vauntro/rika-nex-airflow-controller/hardware/sensorbruecke-as5600/sensorbruecke-as5600-zeichnung.pdf

Fenster 17 × 11, Ecken R 1,5
(Ecken Ø 3 vorbohren, aussägen, feilen)

# Sensorbrücke AS5600 – Rückseite Luftbox

Werkstoff: Alu-Blech 2 mm · Maßstab 1:1 (A4 quer, ohne Seitenanpassung drucken) · Maße in mm · Stand 06.11.2026

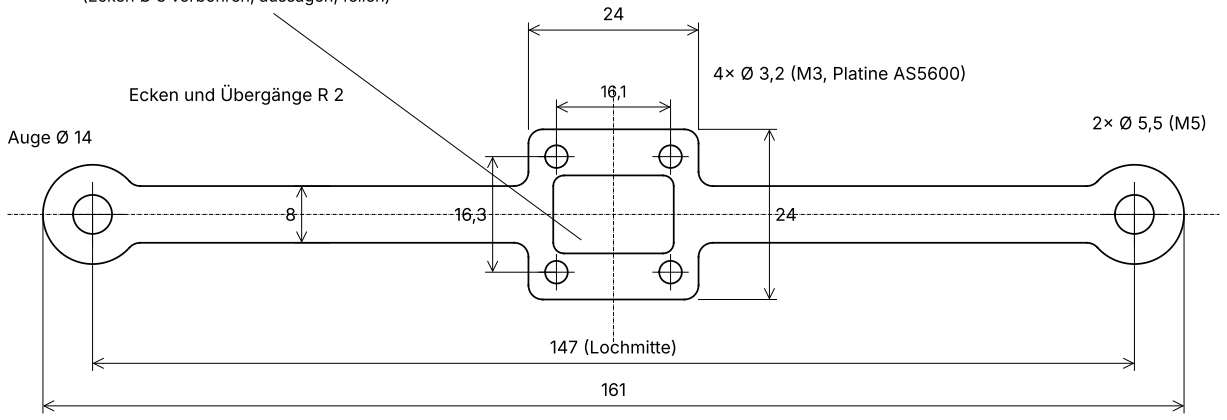
[picture p2: figure]
147 (Lochmitte); 4× Ø 3,2 (M3, Platine AS5600); Auge Ø 14; Ecken und Übergänge R 2

Prüfmaß 50 mm (beim Ausdruck nachmessen)

- Aufbau (von der Box aus): Lasche · Distanzhülse 12 mm · Brücke 2 mm · Scheibe · Mutter, Schraube ISO 4017 M5 × 30, Mutter DIN 985
- Laschenlöcher Ø 6,8 geben ca. ±0,6 mm Spiel: Brücke beim Anziehen so ausrichten, dass das Fenster mittig über der Welle sitzt.
- Platine mit Chip zur Welle auf der Box-Seite der Brücke, 4 Abstandshalter M3 × 6 (Innen/Innen), Schrauben M3 × 5.
- Stack: Magnet 1 vor Laschenebene + Luftspalt ca. 1,9 + Chip 1,5 + Platine 1,6 + Abstandshalter 6 = 12 (Hülsenlänge).
- Luftspalt einstellen: Scheibe M3 zwischen Abstandshalter und Brücke verkleinert den Spalt (je ca. 0,5 mm); Abstandshalter 5 mm → Spalt ca. 2,9 mm.
- AS5600 arbeitet mit Spalt ca. 0,5–3 mm; Feldstärke nach Montage per Firmware prüfen (Status MD/ML/MH).
- Fenster: Dupont-Stecker der Stiftleisten (Stifte zeigen von der Welle weg) gehen nach hinten durch. Platinenlage: Stiftreihen senkrecht.
