vauntro/rika-nex-airflow-controller/hardware/servohalter/bauteil-h-servohalter-abwicklung.pdf

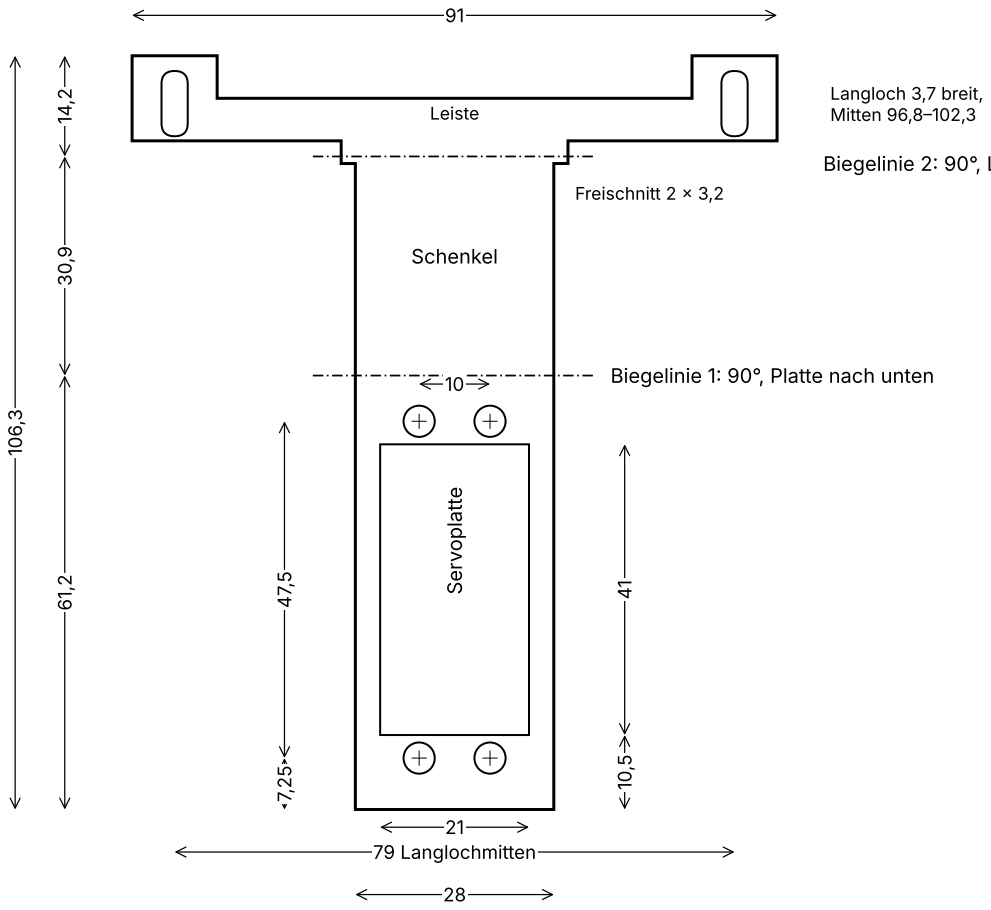
[picture p3: figure]
Biegelinie 1: 90°, Platte nach unten; Servoplatte; Schenkel; Leiste; 79 Langlochmitten; Langloch 3,7 breit, Mitten 96,8–102,3; Freischnitt 2 × 3,2

Biegelinie 2: 90°, Leiste nach unten (gleiche Richtung wie 1)

Kontrolle: 50 mm

Bauteil H – Servohalter, Abwicklung 1:1 (Alublech 2 mm, Biegeradius innen ≈ 2 mm)
Drucken mit 100 % / „Tatsächliche Größe“, dann die 50-mm-Kontrolllinie nachmessen.
Beide Biegungen in dieselbe Richtung: Platte und Leiste zeigen danach nach unten.
Langlöcher am besten erst nach dem Biegen bohren und vorher an der Luftbox den Kanalabstand prüfen (hier 79 mm). Servo-Lochbild 10 × 47,5 vor dem Bohren am Servo nachmessen.
