vauntro/rika-nex-airflow-controller/docs/rika-nex-manuelle-luftsteuerung.md

# RIKA NEX: manuelle Luftsteuerung

Zusammenfassung der manuellen Luftsteuerung und der dokumentierten Fühlerposition. Zur Luftsteuerung siehe das Kapitel **„Manuelle Bedienung“, Seite 12** der NEX-Anleitung.[1]

## Funktionsprinzip

Ein gemeinsamer Regler steuert Primär- und Sekundärluft. Die Mittelstellung bedeutet nicht „halbe Luftmenge“.[1]

| Reglerstellung | Primärluft | Sekundärluft |
|---|---|---|
| Anheizstellung | 100 % offen | 100 % offen |
| Mittelstellung | geschlossen | 100 % offen |
| Nullstellung | geschlossen | geschlossen |

Von der Mittelstellung Richtung Null wird die Sekundärluft gedrosselt.[1]

## Luftwege

- **Primärluft / Unterluft:** gelangt durch Aschenraum und Rost von unten zum Brennstoff und dient insbesondere dem Anheizen.[2]
- **Sekundärluft / Oberluft:** strömt entlang der Scheibeninnenseite in den Feuerraum, unterstützt die Verbrennung der Holzgase und dient als Scheibenspülung. Nach dem Anheizen erfolgt die Regelung über diesen Luftweg.[2]

## Bedienablauf

1. **Anheizen:** beide Luftwege öffnen.
2. **Nach dem Anheizen:** auf Mittelstellung wechseln, anschließend bei Bedarf weiter Richtung Null regeln.
3. **Nachlegen:** erneut Anheizstellung wählen, bis das nachgelegte Holz gut angebrannt ist.[1]

Die passende Einstellung hängt unter anderem von Kaminzug, Holzqualität und Auflagemenge ab; feste Minutenwerte sind nicht vorgegeben.[1]

> **Sicherheit:** Die Nullstellung darf während des Betriebs nicht verwendet werden – Verpuffungsgefahr. Sie ist für den Stillstand vorgesehen.[1]

## Position des Brennraumtemperaturfühlers

Die folgende Lagebeschreibung ist aus der Wartungsabbildung auf **Seite 19** der NEX-Anleitung abgeleitet. Als Blickrichtung gilt der Blick durch die geöffnete Feuerraumtür nach oben in den Brennraum.[3]

- **Höhenlage:** Der Fühler befindet sich ganz oben im Brennraum, im Bereich der oberen Umlenkplatte beziehungsweise der Brennraumdecke, deutlich oberhalb des Holzauflagebereichs.[3]
- **Sichtbare Stelle:** Die kurze Fühlerspitze ist in einer schmalen, länglichen Aussparung der oberen Platte erkennbar.[3]
- **Eintritt in die Aussparung:** Die Spitze ragt seitlich in diese Öffnung hinein; sichtbar ist nur das kurze, freiliegende Fühlerende.[3]
- **Seitliche Zuordnung:** Die Aussparung liegt in der Herstellerzeichnung links von der Bildmitte. Diese Angabe bezieht sich auf die dargestellte Ansicht und ist keine vermaßte Links-rechts-Position am Ofen.[3]
- **Räumliche Abgrenzung:** Der dargestellte Messort liegt im oberen Brennraumbereich, nicht am Rost und nicht außen am Rauchrohr.[3]

**Genauigkeitsgrenze:** Die Abbildung enthält keine Maße für Einstecktiefe, Wandabstand oder Höhe über dem Rost. Der verdeckte Fühlerverlauf und seine Befestigung lassen sich daraus nicht zuverlässig bestimmen. Die Beschreibung legt daher die erkennbare Position fest, nicht millimetergenaue Einbaumaße.[3]

## Grenzen der Dokumentation

Die Anleitung dokumentiert die Grundstellungen und den Bedienablauf, jedoch keine quantitative Kennlinie für Zwischenstellungen oder genaue innere Schiebergeometrie. Aus dem prozentualen Reglerweg lässt sich deshalb keine belegte prozentuale Luftmenge ableiten.[1]

## Sources

[1] https://rika.ams3.cdn.digitaloceanspaces.com/rika-web/ovens/nex/pdf/DE/Z36267_Nex_R4_DE.pdf
[2] https://www.rika.de/faqs
[3] https://www.ofenexperte.de/pub/more_downloads/rika-nex-rikatronic-bedienungsanleitung.pdf
