vauntro/rika-nex-airflow-controller/hardware/sensorbruecke-as5600/entwurf/skizze-sensorhalter-as5600.png

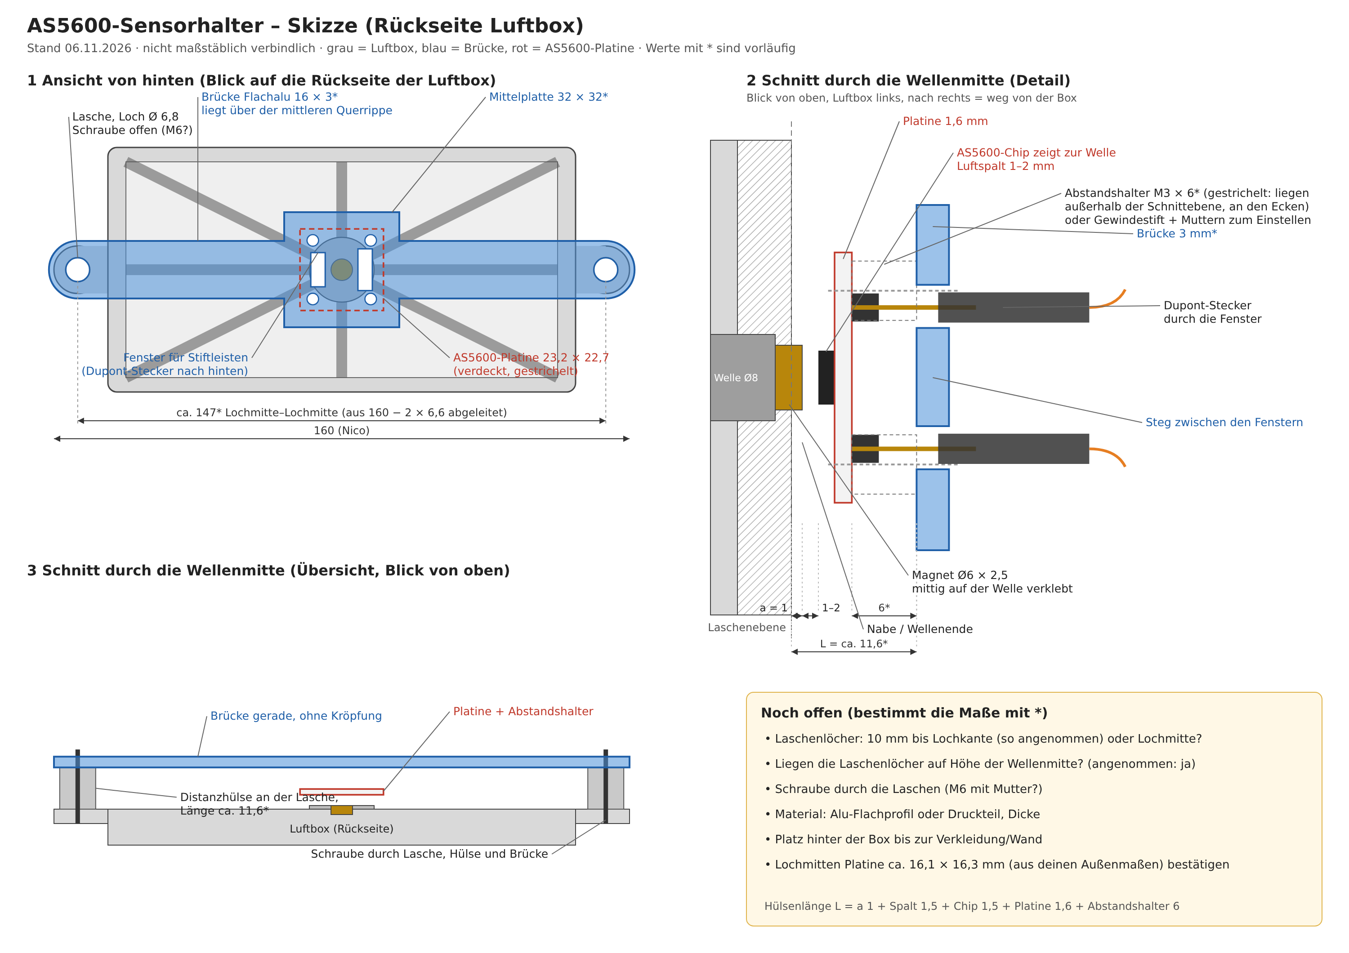
hardware/sensorbruecke-as5600/entwurf/skizze-sensorhalter-as5600.png
