vauntro/rika-nex-airflow-controller/hardware/sensorbruecke-as5600/entwurf/varianten-a-b.png

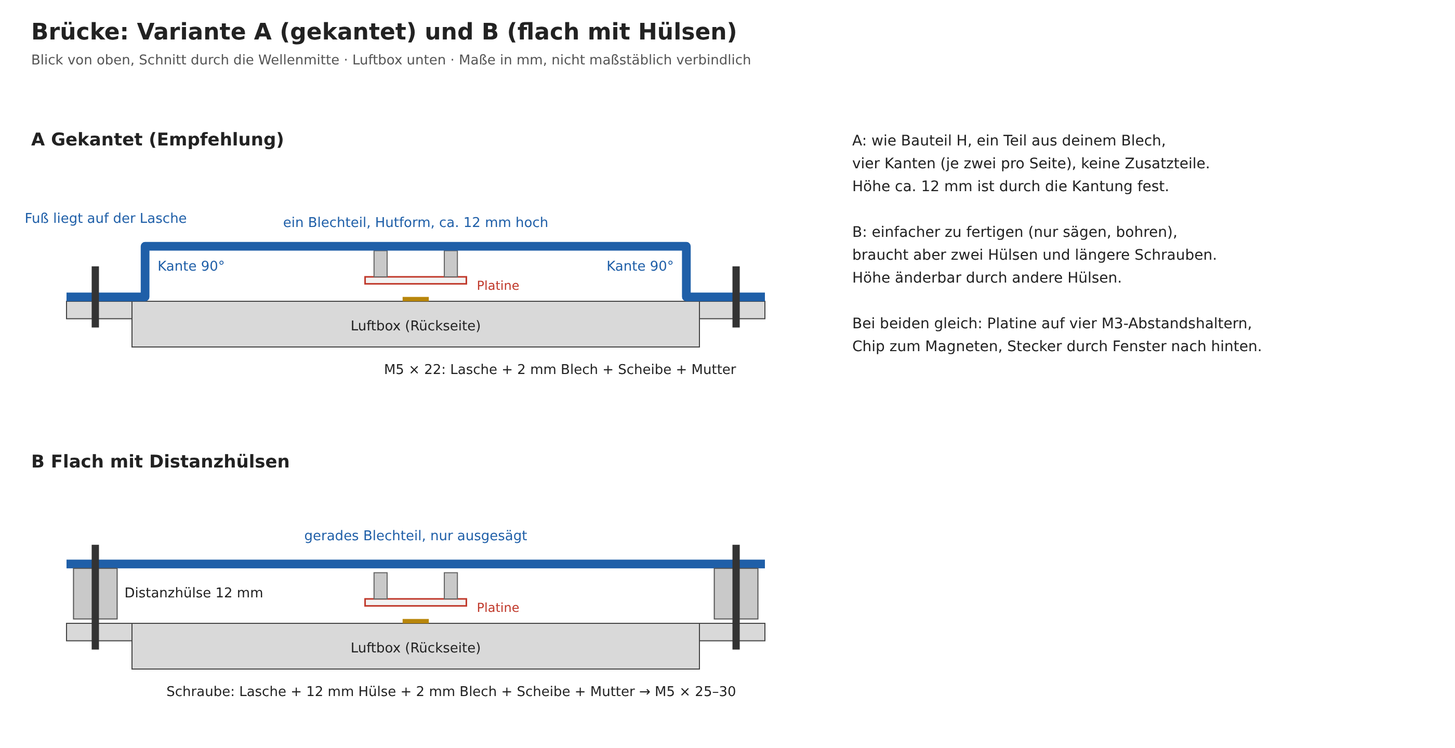
hardware/sensorbruecke-as5600/entwurf/varianten-a-b.png
