vauntro/rika-nex-airflow-controller/hardware/sensorbruecke-as5600/sensorbruecke-as5600-baugruppe.png

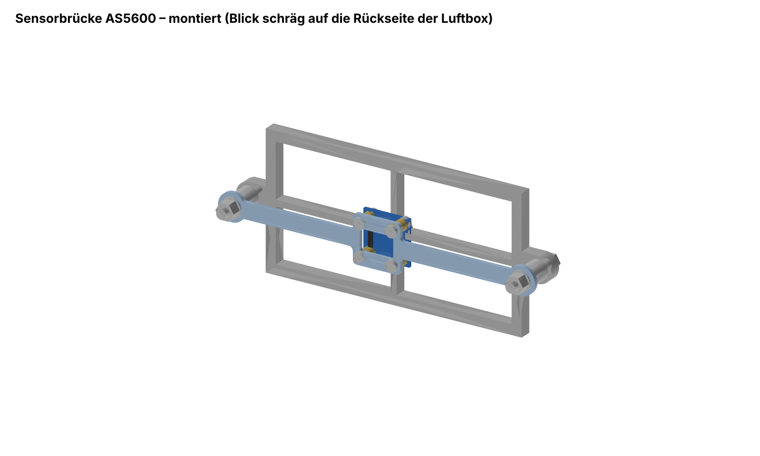
hardware/sensorbruecke-as5600/sensorbruecke-as5600-baugruppe.png
