vauntro/rika-nex-airflow-controller/hardware/sensorbruecke-as5600/sensorbruecke-as5600-zeichnung.png

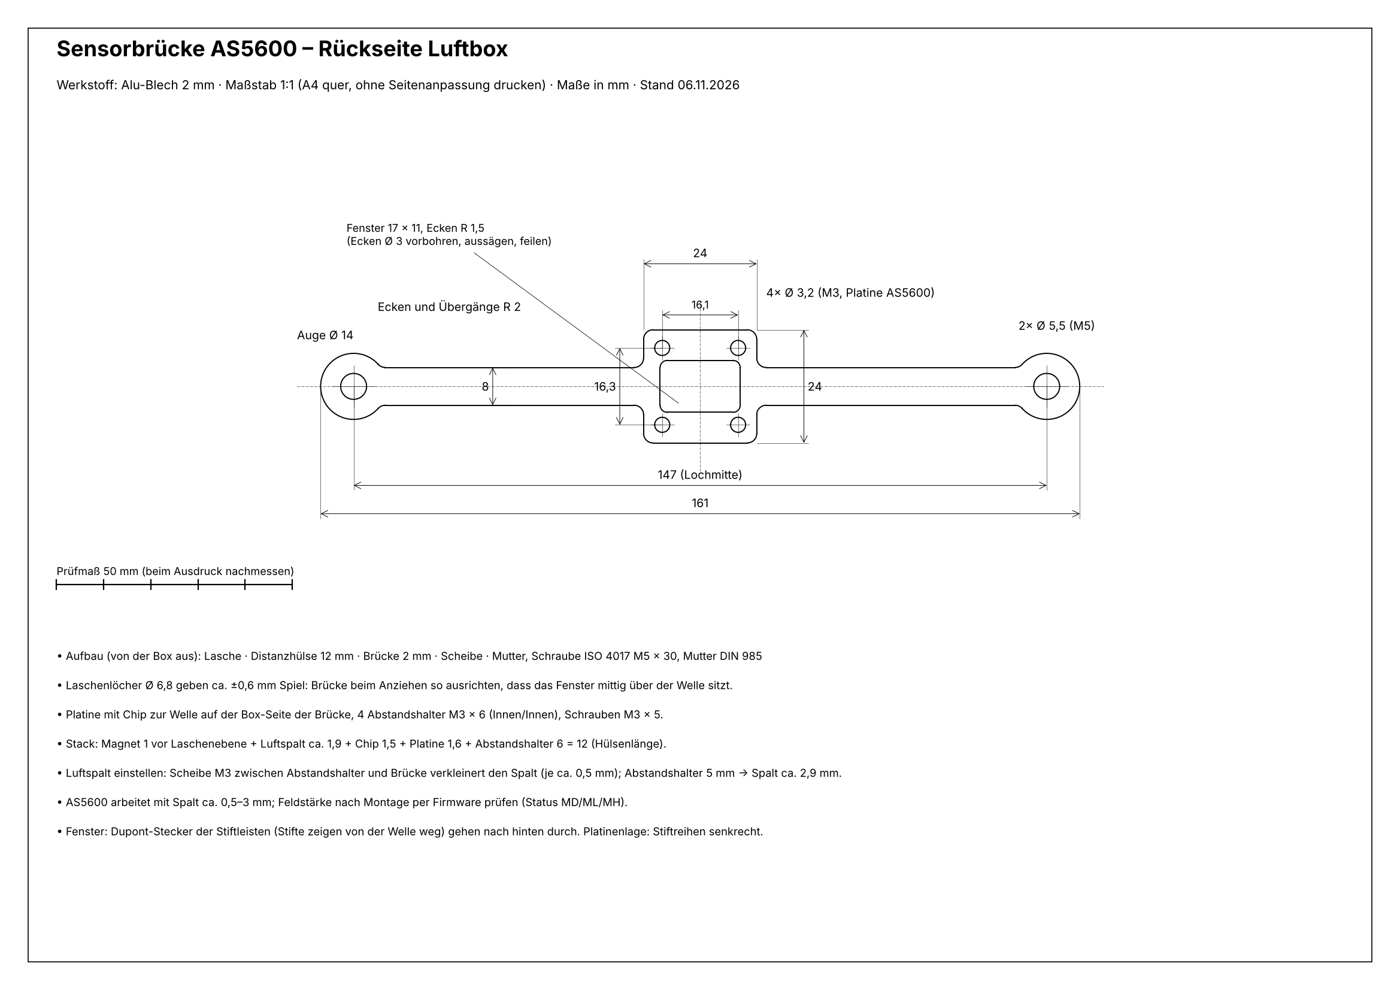
hardware/sensorbruecke-as5600/sensorbruecke-as5600-zeichnung.png
