vauntro/rika-nex-airflow-controller/hardware/servohalter/bauteil-h-servohalter-3d.png

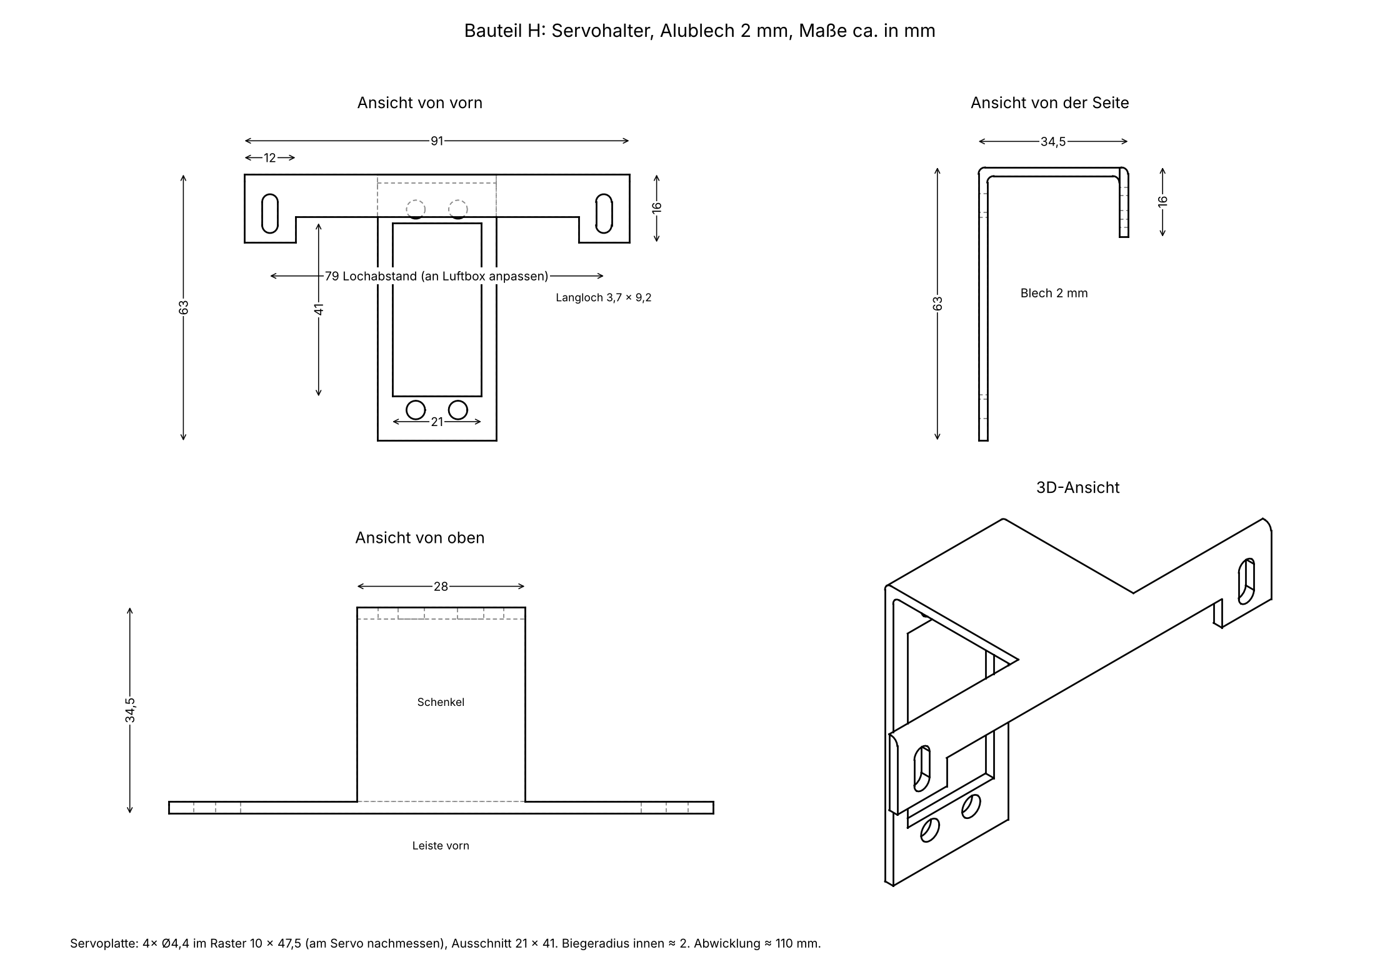
hardware/servohalter/bauteil-h-servohalter-3d.png
