vauntro/rika-nex-airflow-controller/hardware/servohalter/bauteil-h-servohalter-abwicklung.png

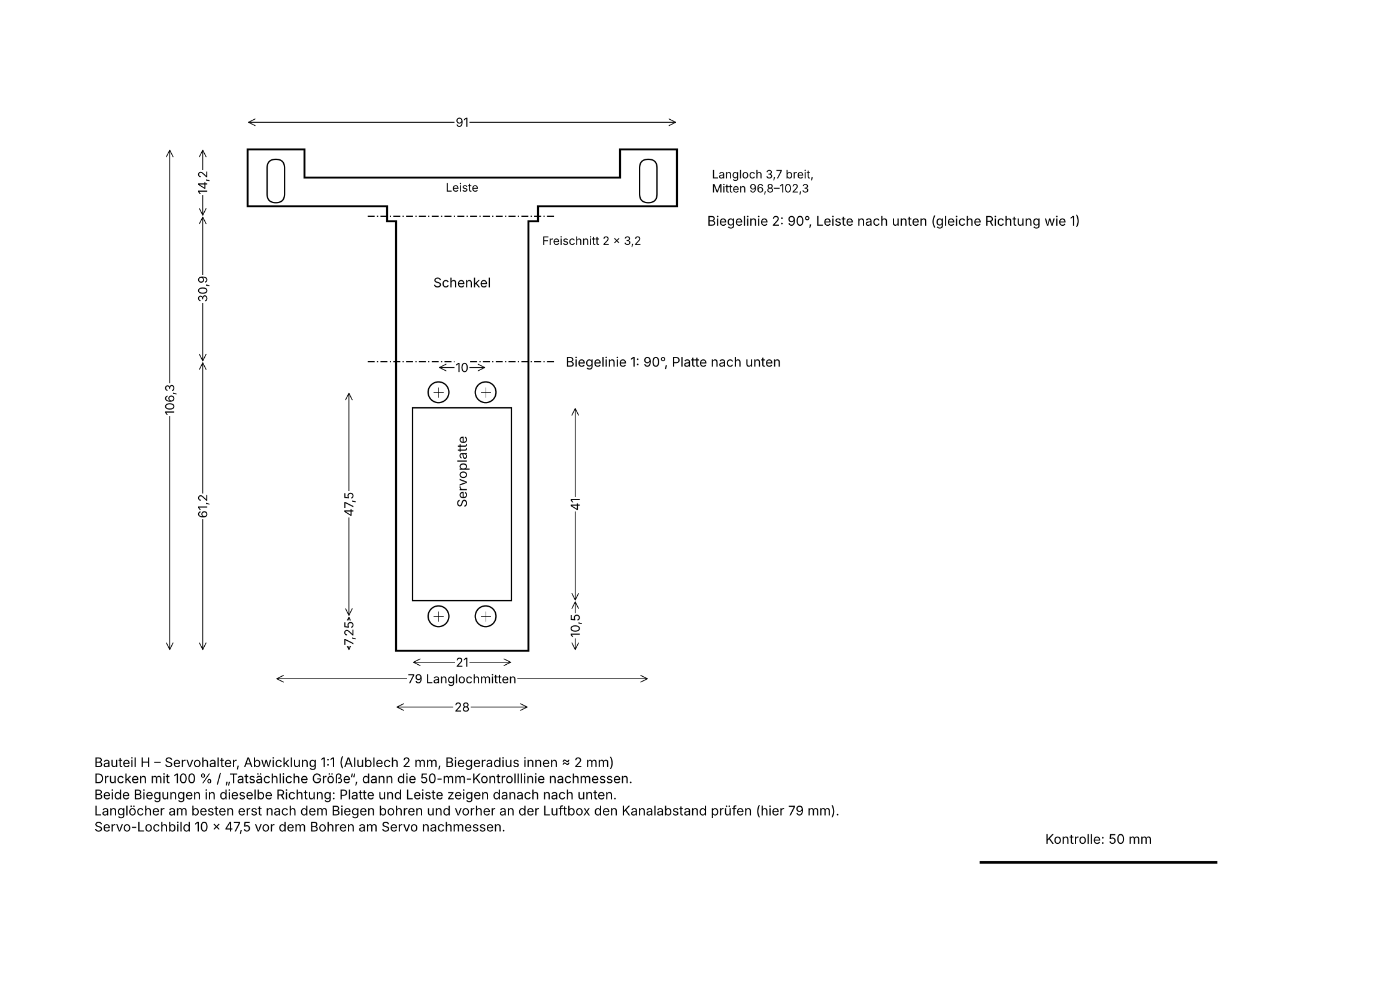
hardware/servohalter/bauteil-h-servohalter-abwicklung.png
