vauntro/rika-nex-airflow-controller/hardware/servohalter/bauteil-h-servohalter-masse.png

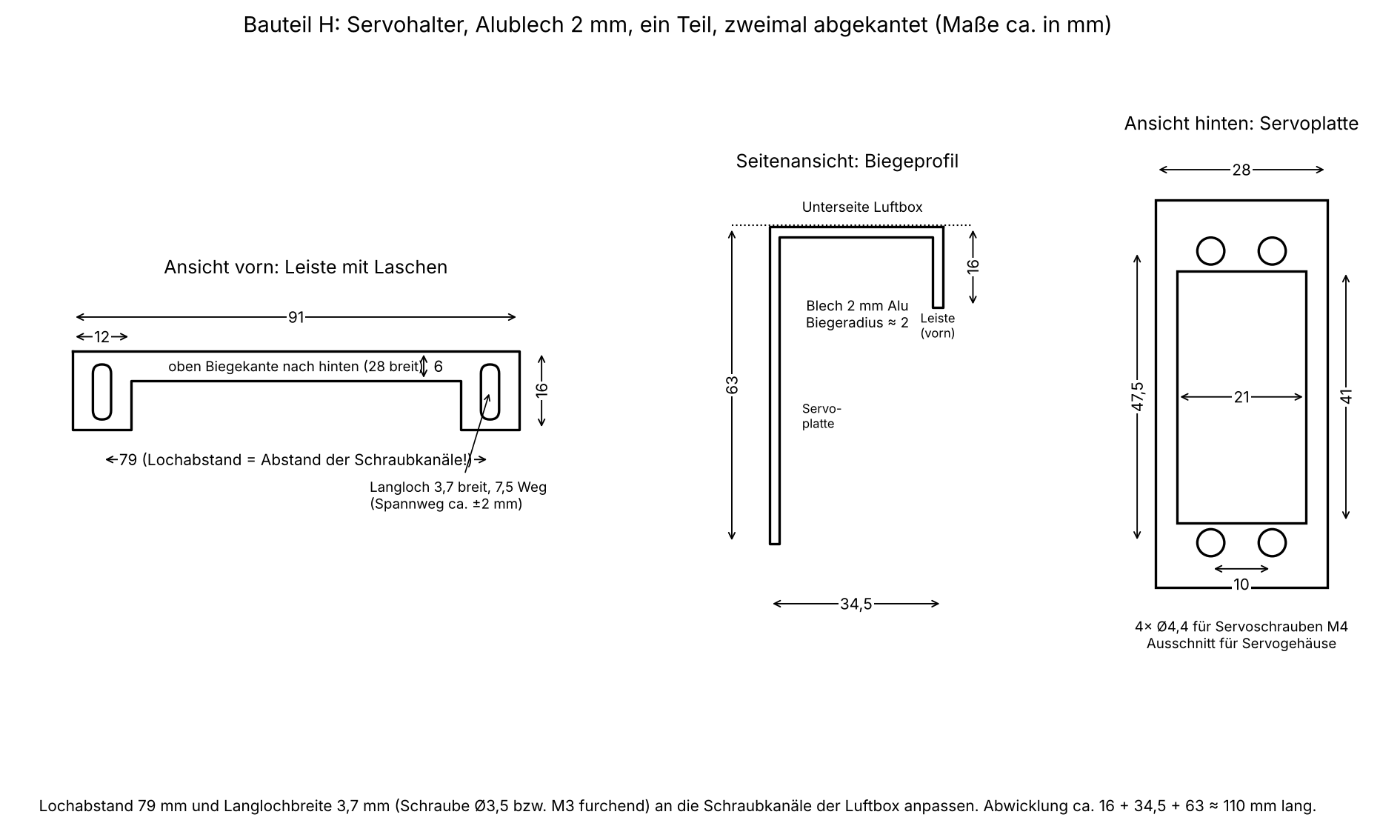
hardware/servohalter/bauteil-h-servohalter-masse.png
