vauntro/rika-nex-airflow-controller/hardware/sensorbruecke-as5600/sensorbruecke-as5600-baugruppe-explosion.step

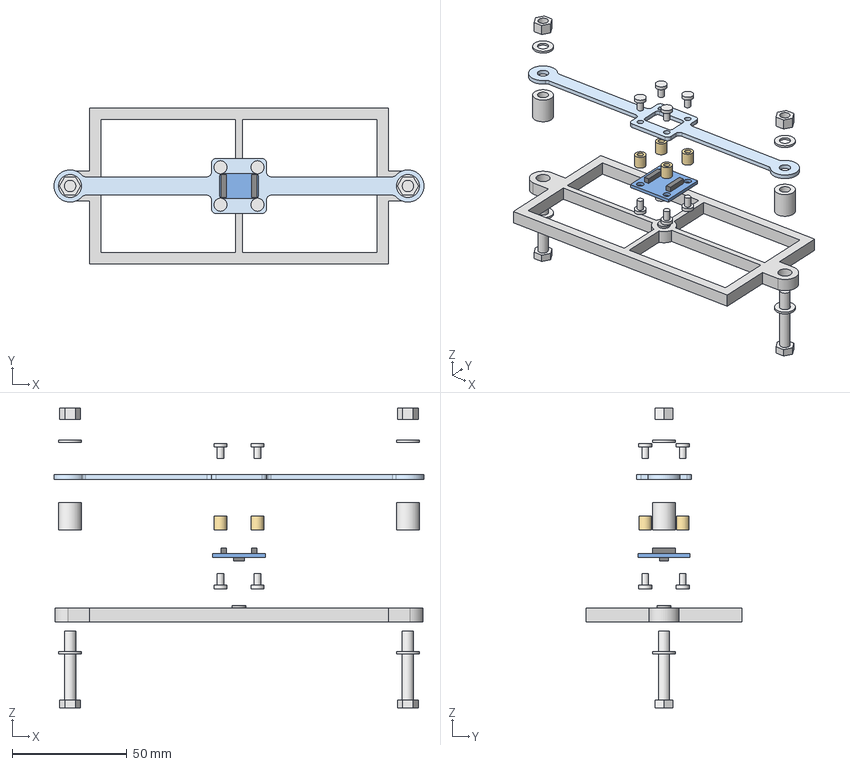
[picture p12: CAD file, 2026-11-06]
hardware/sensorbruecke-as5600/sensorbruecke-as5600-baugruppe-explosion.step
161.0 x 68.0 x 130.5 mm
01_Luftbox_Rueckseite_1
02_Magnet_1
07_ISO7380_M3x5_1
04_Abstandshalter_M3x6_1
07_ISO7380_M3x5_2
07_ISO7380_M3x5_3
04_Abstandshalter_M3x6_2
07_ISO7380_M3x5_4
07_ISO7380_M3x5_5
04_Abstandshalter_M3x6_3
07_ISO7380_M3x5_6
07_ISO7380_M3x5_7
04_Abstandshalter_M3x6_4
07_ISO7380_M3x5_8
03_AS5600_Platine_1
03_AS5600_Platine_2
03_AS5600_Platine_3
03_AS5600_Platine_4
05_Sensorbruecke_1
06_Distanzhuelse_12_1
09_Scheibe_ISO7089_5_1
10_Mutter_DIN985_M5_1
09_Scheibe_ISO7089_5_2
08_ISO4017_M5x30_1
06_Distanzhuelse_12_2
09_Scheibe_ISO7089_5_3
10_Mutter_DIN985_M5_2
09_Scheibe_ISO7089_5_4
08_ISO4017_M5x30_2
