vauntro/rika-nex-airflow-controller/hardware/riemenrad/riemenrad-gt2-20t-servo25t.step

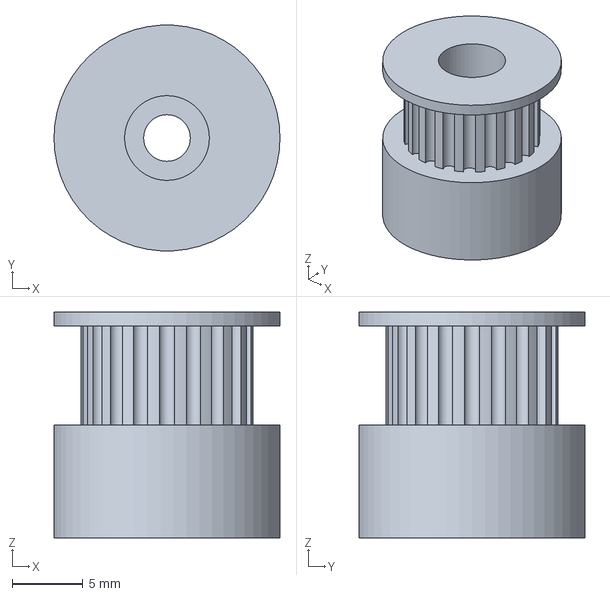
[picture p13: CAD file, 2026-10-27]
hardware/riemenrad/riemenrad-gt2-20t-servo25t.step
16.0 x 16.0 x 16.0 mm
