vauntro/rika-nex-airflow-controller/hardware/servohalter/bauteil-h-servohalter.step

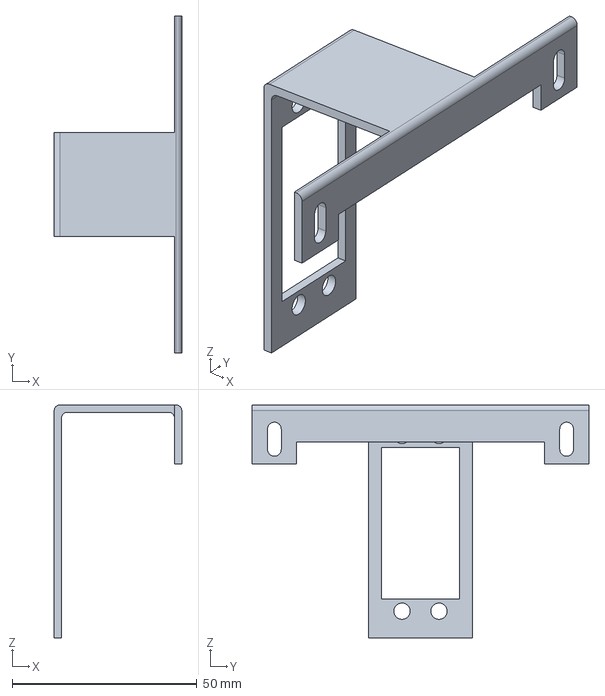
[picture p14: CAD file, 2026-10-27]
hardware/servohalter/bauteil-h-servohalter.step
34.5 x 91.0 x 63.0 mm
