vauntro/rika-nex-airflow-controller/hardware/sensorbruecke-as5600/sensorbruecke-as5600.step

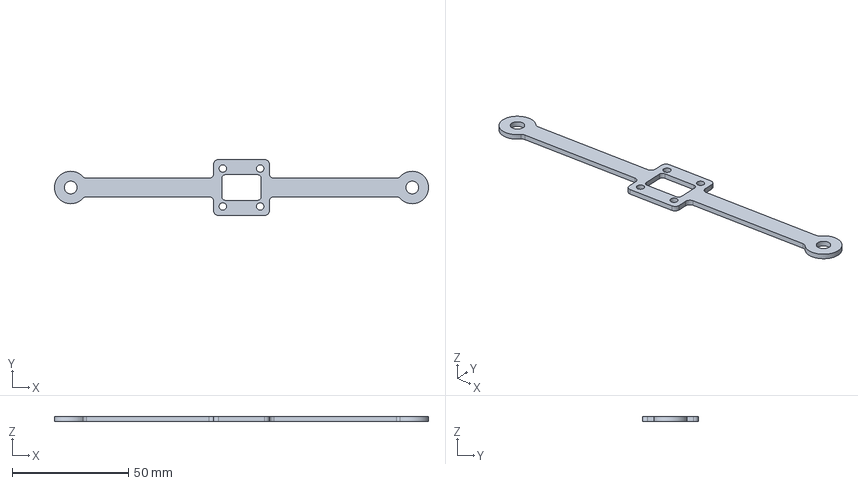
[picture p15: CAD file, 2026-11-06]
hardware/sensorbruecke-as5600/sensorbruecke-as5600.step
161.0 x 24.0 x 2.00 mm
