vauntro/rika-nex-airflow-controller/(list of files, cad)

Other CAD files:
hardware/riemenrad/riemenrad-gt2-20t-servo25t.stl
hardware/sensorbruecke-as5600/sensorbruecke-as5600-baugruppe-explosion.stl
hardware/sensorbruecke-as5600/sensorbruecke-as5600-baugruppe-montiert.stl
hardware/sensorbruecke-as5600/sensorbruecke-as5600.dxf
hardware/sensorbruecke-as5600/sensorbruecke-as5600.stl
hardware/servohalter/bauteil-h-servohalter.stl
