vauntro/rika-nex-airflow-controller/hardware/sensorbruecke-as5600/sensorbruecke-as5600-montage.pdf

# Sensorbrücke AS5600 – Montage (Explosionsdarstellung)

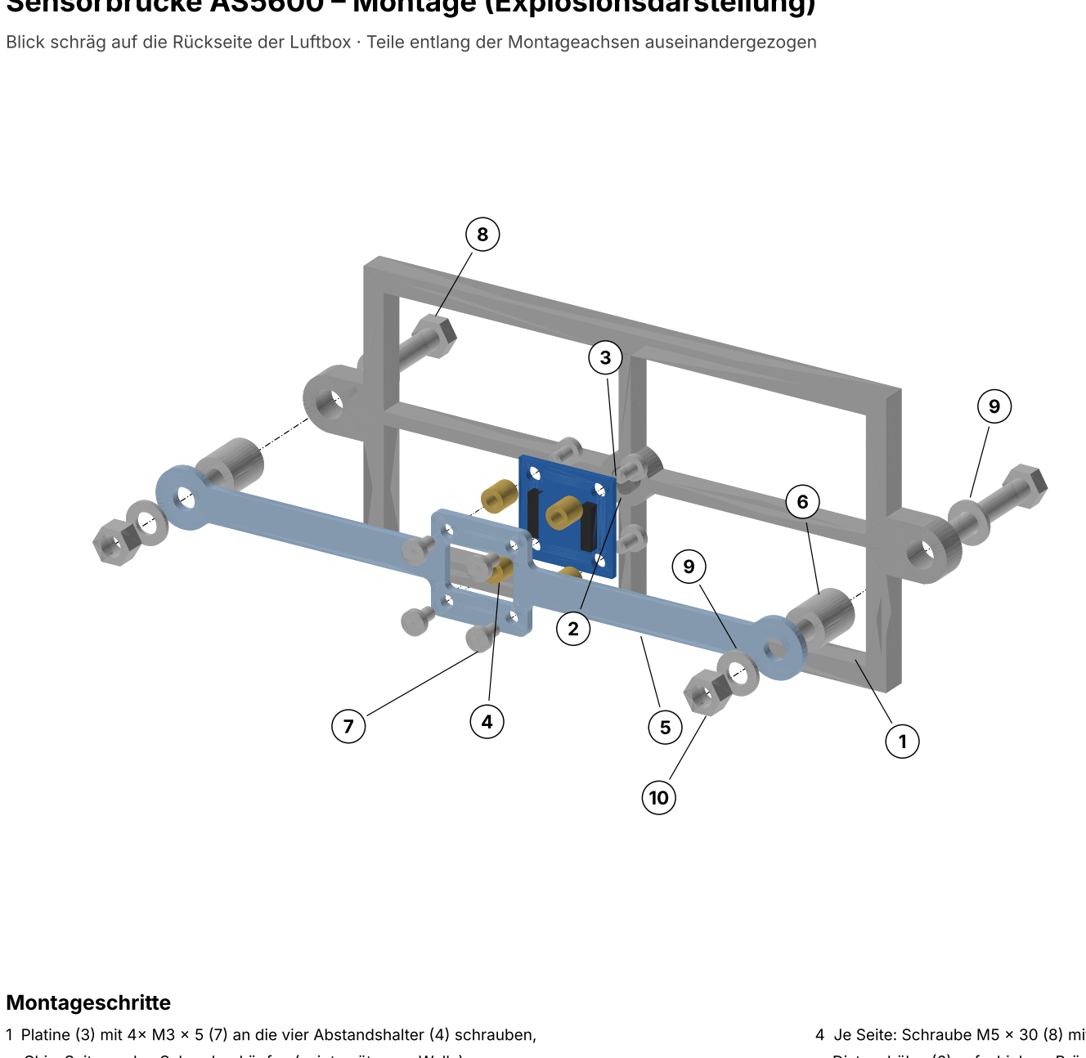
[picture p16: figure]
Montageschritte

Blick schräg auf die Rückseite der Luftbox · Teile entlang der Montageachsen auseinandergezogen

## Teileliste

Pos. Benennung | Stk.
1 | Luftbox-Rückseite, mittlere Laschen (6,2 dick, Ø6,8)vorhanden
2 | Magnet Ø6 × 2,5, mittig auf dem Wellenende | vorhanden
3 | AS5600-Platine, Chip zur Welle | 1
4 | Abstandshalter M3 × 6, innen/innen, Messing | 4
5 | Sensorbrücke, Alu 2 mm (RNX-S-001) | 1
6 | Distanzhülse 12, Ø10/5,3 | 2
7 | ISO 7380 M3 × 5 – A2 | 8
8 | ISO 4017 M5 × 30 – A2 | 2
9 | Scheibe ISO 7089 – 5 – A2 | 4
10 | Sicherungsmutter DIN 985 M5 – A2 | 2

1 Platine (3) mit 4× M3 × 5 (7) an die vier Abstandshalter (4) schrauben, Chip-Seite zu den Schraubenköpfen (zeigt später zur Welle).

2 Abstandshalter mit 4× M3 × 5 (7) von außen an der Brücke (5) befestigen,

Stiftleisten durch das Fenster, Stiftreihen senkrecht.

3 Dupont-Kabel durch das Fenster auf die Stiftleisten stecken.

4 Je Seite: Schraube M5 × 30 (8) mit Scheibe (9) von hinten durch die Lasche (1),

Distanzhülse (6) aufschieben, Brücke aufsetzen, Scheibe (9), Mutter (10) handfest.

5 Brücke ausrichten: Chip mittig über dem Magneten (2), dann Muttern anziehen.
6 Feldstärke prüfen (MD/ML/MH), ggf. Spalt mit M3-Scheiben unter den

Abstandshaltern verkleinern, Nullpunkt neu setzen.
