vauntro/rika-nex-airflow-controller/hardware/sensorbruecke-as5600/sensorbruecke-as5600-montage.png

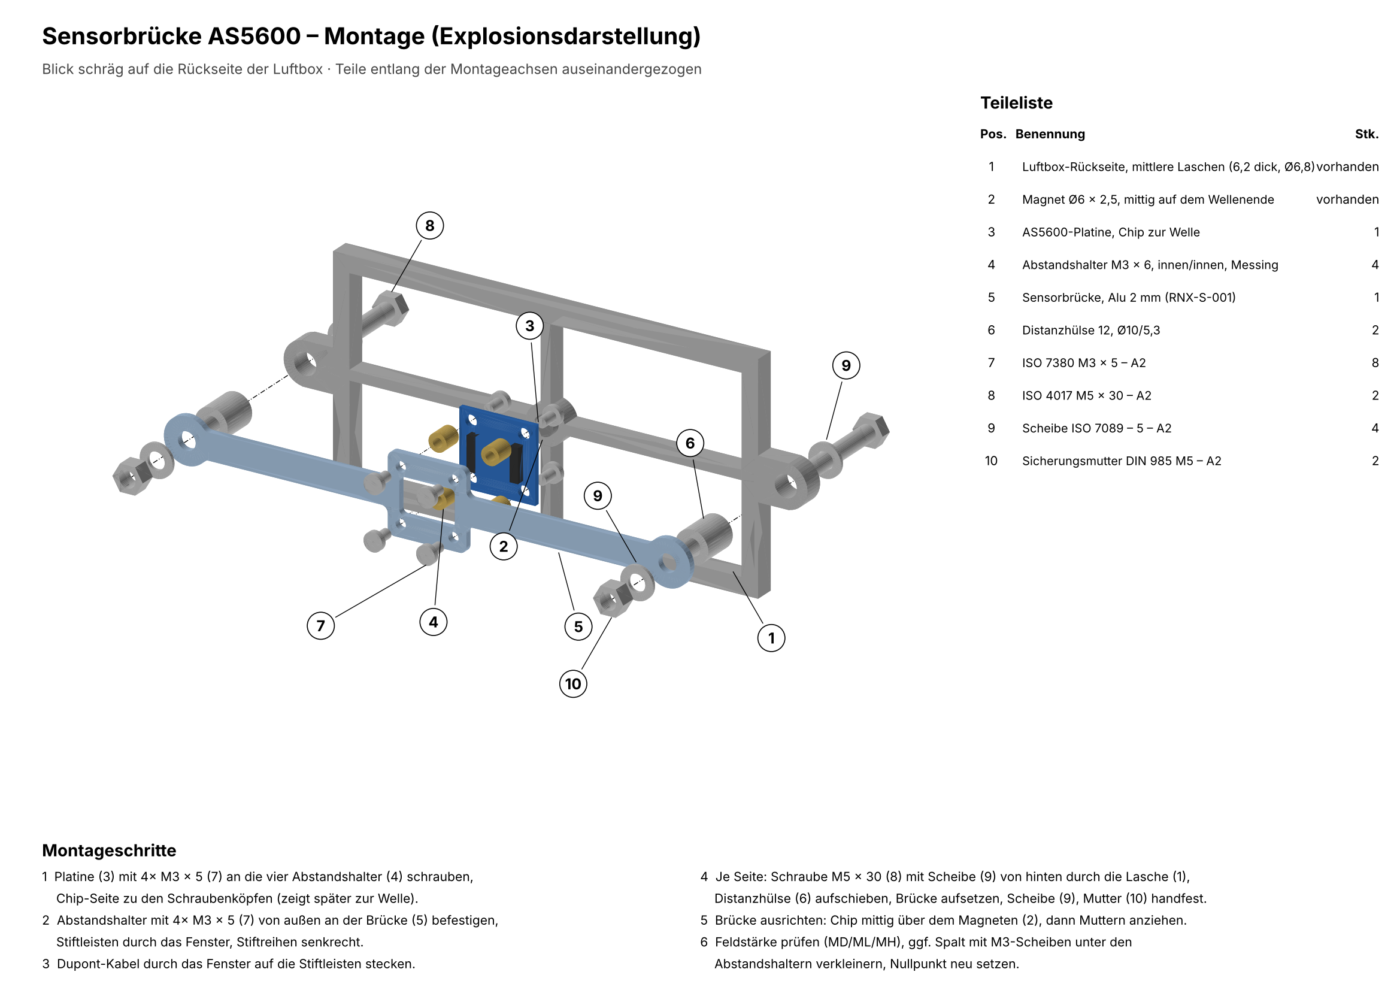
hardware/sensorbruecke-as5600/sensorbruecke-as5600-montage.png
