vauntro/rika-nex-airflow-controller/hardware/sensorbruecke-as5600/sensorbruecke-as5600-zeichnung-iso.pdf

1

2

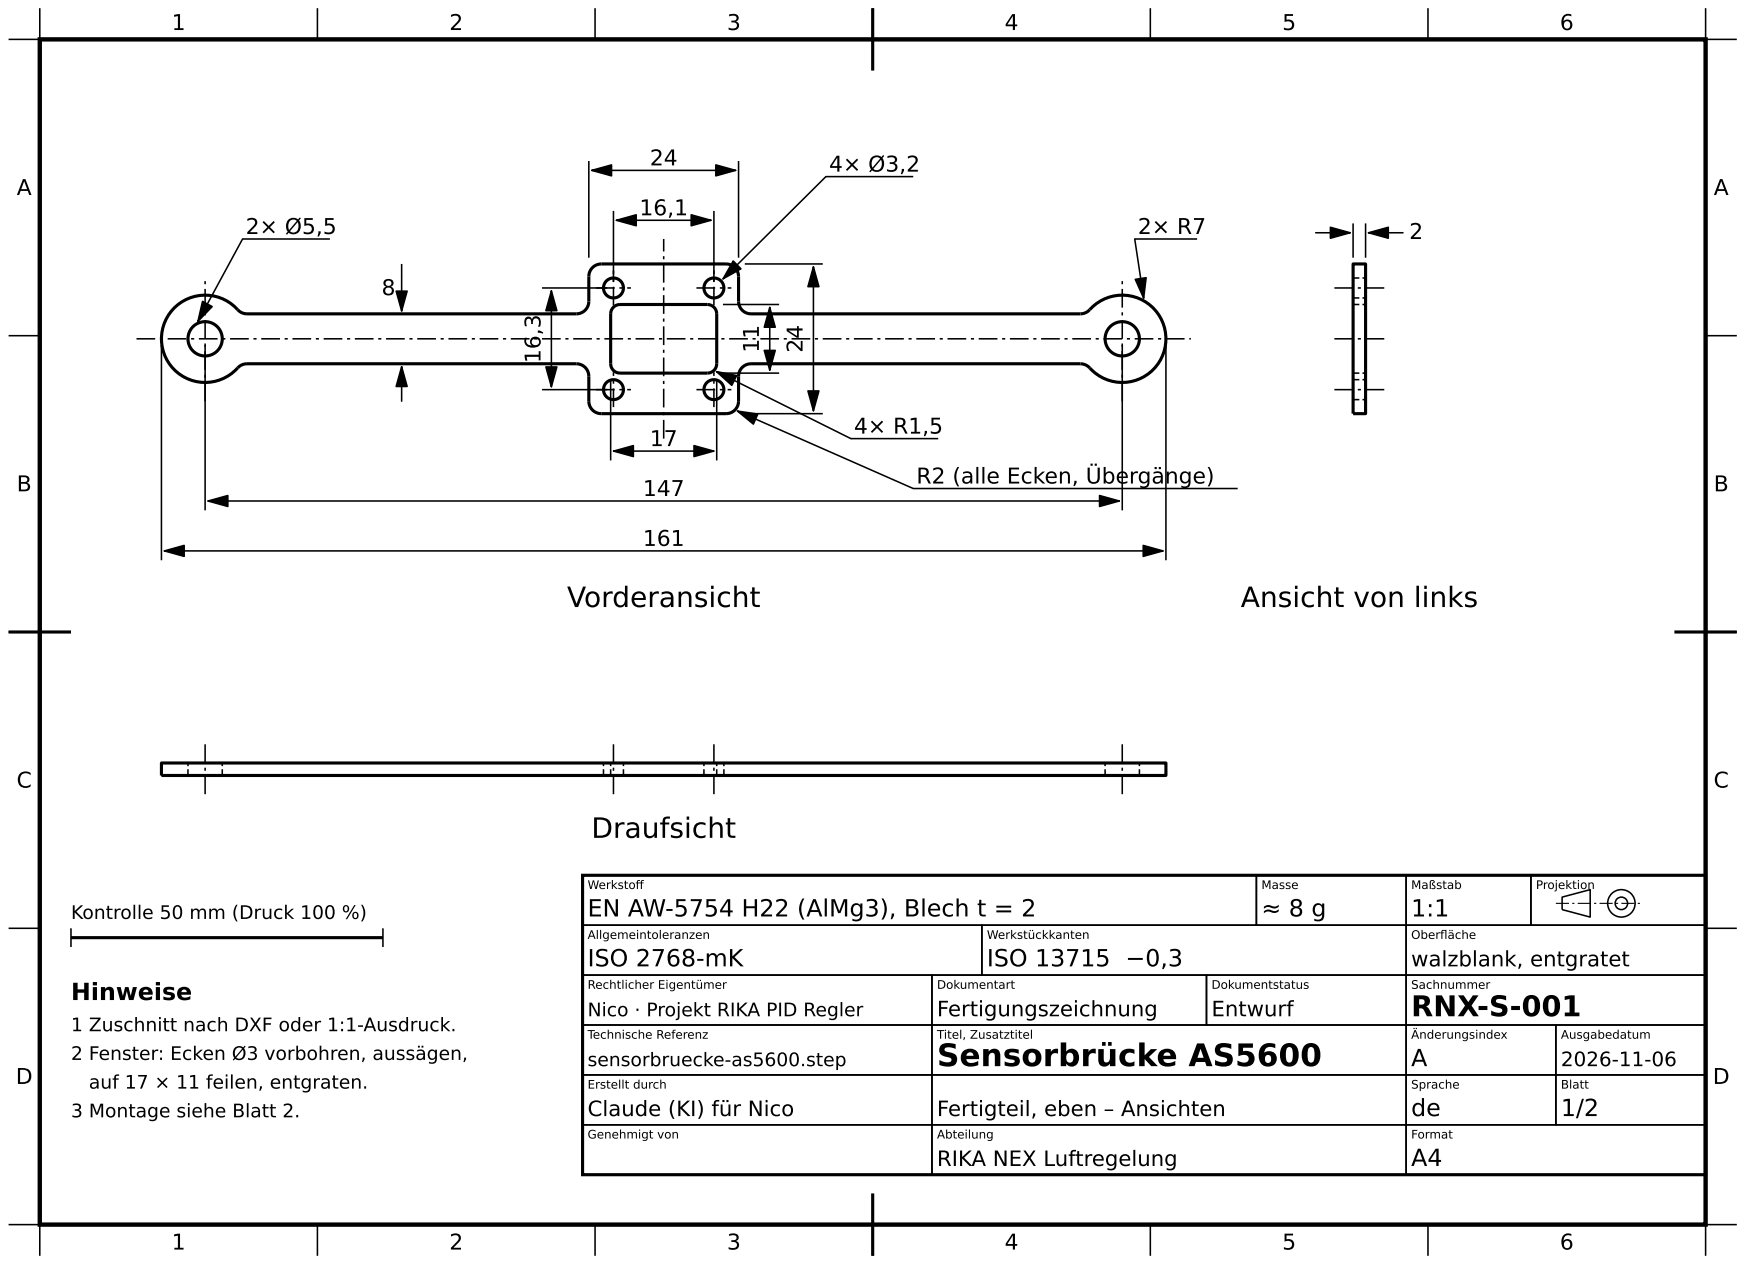
[picture p18: page 1]
Vorderansicht; Draufsicht; Hinweise; Masse ≈ 8 g; Maßstab 1:1; Projektion; Allgemeintoleranzen ISO 2768-mK; Werkstückkanten ISO 13715 −0,3; Oberfläche walzblank, entgratet; Dokumentart Fertigungszeichnung; Dokumentstatus Entwurf; Sachnummer RNX-S-001; Technische Referenz sensorbruecke-as5600.step; Titel, Zusatztitel Sensorbrücke AS5600; Änderungsindex A; Ausgabedatum 2026-11-06; Erstellt durch; Claude (KI) für Nico; Fertigteil, eben – Ansichten; Sprache de; Blatt 1/2; Genehmigt von; Abteilung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

R2 (alle Ecken, Übergänge)

Ansicht von links

Werkstoff
EN AW-5754 H22 (AlMg3), Blech t = 2

Kontrolle 50 mm (Druck 100 %)

Rechtlicher Eigentümer
Nico · Projekt RIKA PID Regler

1 Zuschnitt nach DXF oder 1:1-Ausdruck.
2 Fenster: Ecken Ø3 vorbohren, aussägen,

auf 17 × 11 feilen, entgraten.
3 Montage siehe Blatt 2.

RIKA NEX Luftregelung

1

2

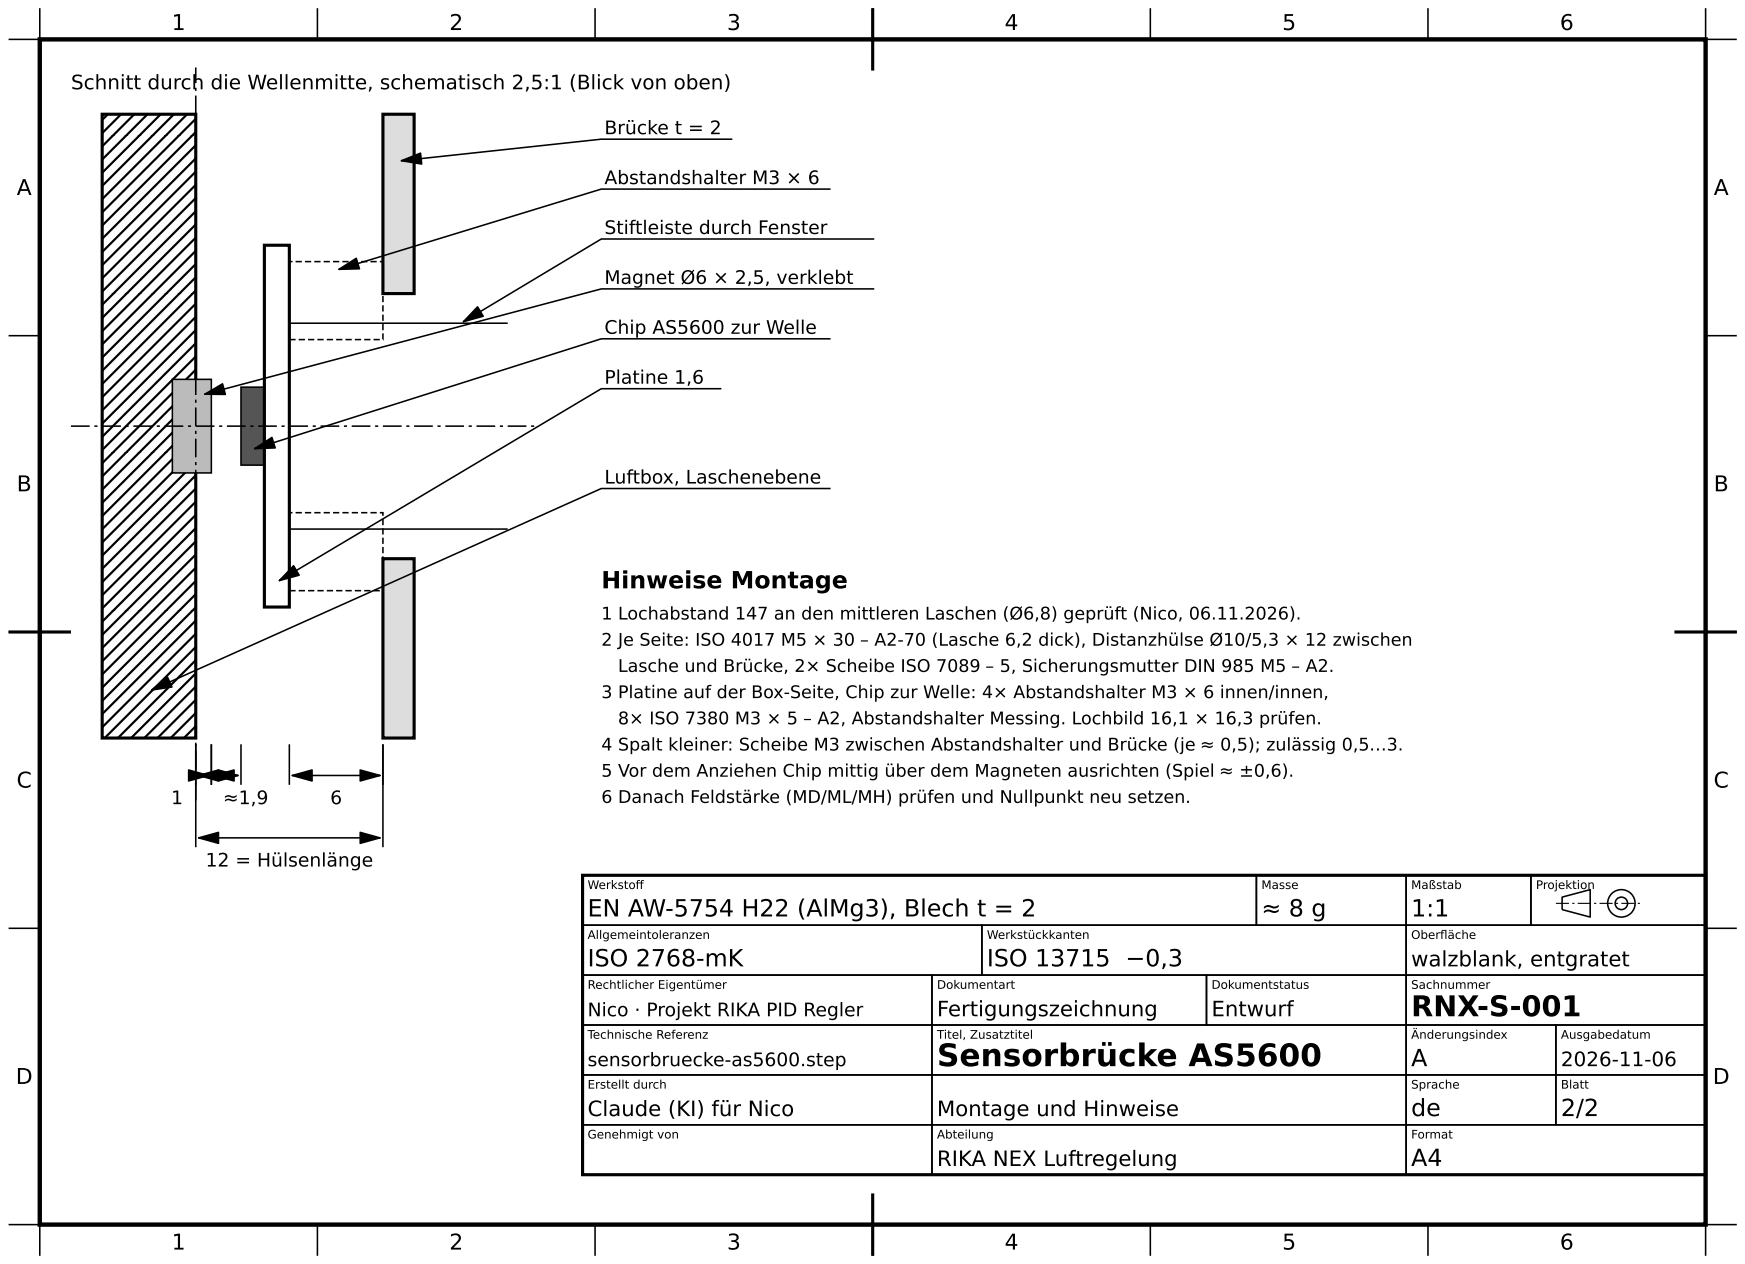
[picture p19: page 2]
12 = Hülsenlänge; Brücke t = 2; Abstandshalter M3 × 6; Magnet Ø6 × 2,5, verklebt; Platine 1,6; Luftbox, Laschenebene; Hinweise Montage; Masse ≈ 8 g; Maßstab 1:1; Projektion; Allgemeintoleranzen ISO 2768-mK; Werkstückkanten ISO 13715 −0,3; Oberfläche walzblank, entgratet; Dokumentart Fertigungszeichnung; Dokumentstatus Entwurf; Sachnummer RNX-S-001; Technische Referenz sensorbruecke-as5600.step; Titel, Zusatztitel Sensorbrücke AS5600; Änderungsindex A; Ausgabedatum 2026-11-06; Erstellt durch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

Schnitt durch die Wellenmitte, schematisch 2,5:1 (Blick von oben)

Stiftleiste durch Fenster

Chip AS5600 zur Welle

1 Lochabstand 147 an den mittleren Laschen (Ø6,8) geprüft (Nico, 06.11.2026).
2 Je Seite: ISO 4017 M5 × 30 – A2-70 (Lasche 6,2 dick), Distanzhülse Ø10/5,3 × 12 zwischen
Lasche und Brücke, 2× Scheibe ISO 7089 – 5, Sicherungsmutter DIN 985 M5 – A2.

3 Platine auf der Box-Seite, Chip zur Welle: 4× Abstandshalter M3 × 6 innen/innen,
8× ISO 7380 M3 × 5 – A2, Abstandshalter Messing. Lochbild 16,1 × 16,3 prüfen.
4 Spalt kleiner: Scheibe M3 zwischen Abstandshalter und Brücke (je ≈ 0,5); zulässig 0,5…3.
5 Vor dem Anziehen Chip mittig über dem Magneten ausrichten (Spiel ≈ ±0,6).

6 Danach Feldstärke (MD/ML/MH) prüfen und Nullpunkt neu setzen.

Werkstoff
EN AW-5754 H22 (AlMg3), Blech t = 2

Rechtlicher Eigentümer
Nico · Projekt RIKA PID Regler

RIKA NEX Luftregelung
