vauntro/rika-nex-airflow-controller/hardware/servohalter/bauteil-h-servohalter-zeichnung-iso.pdf

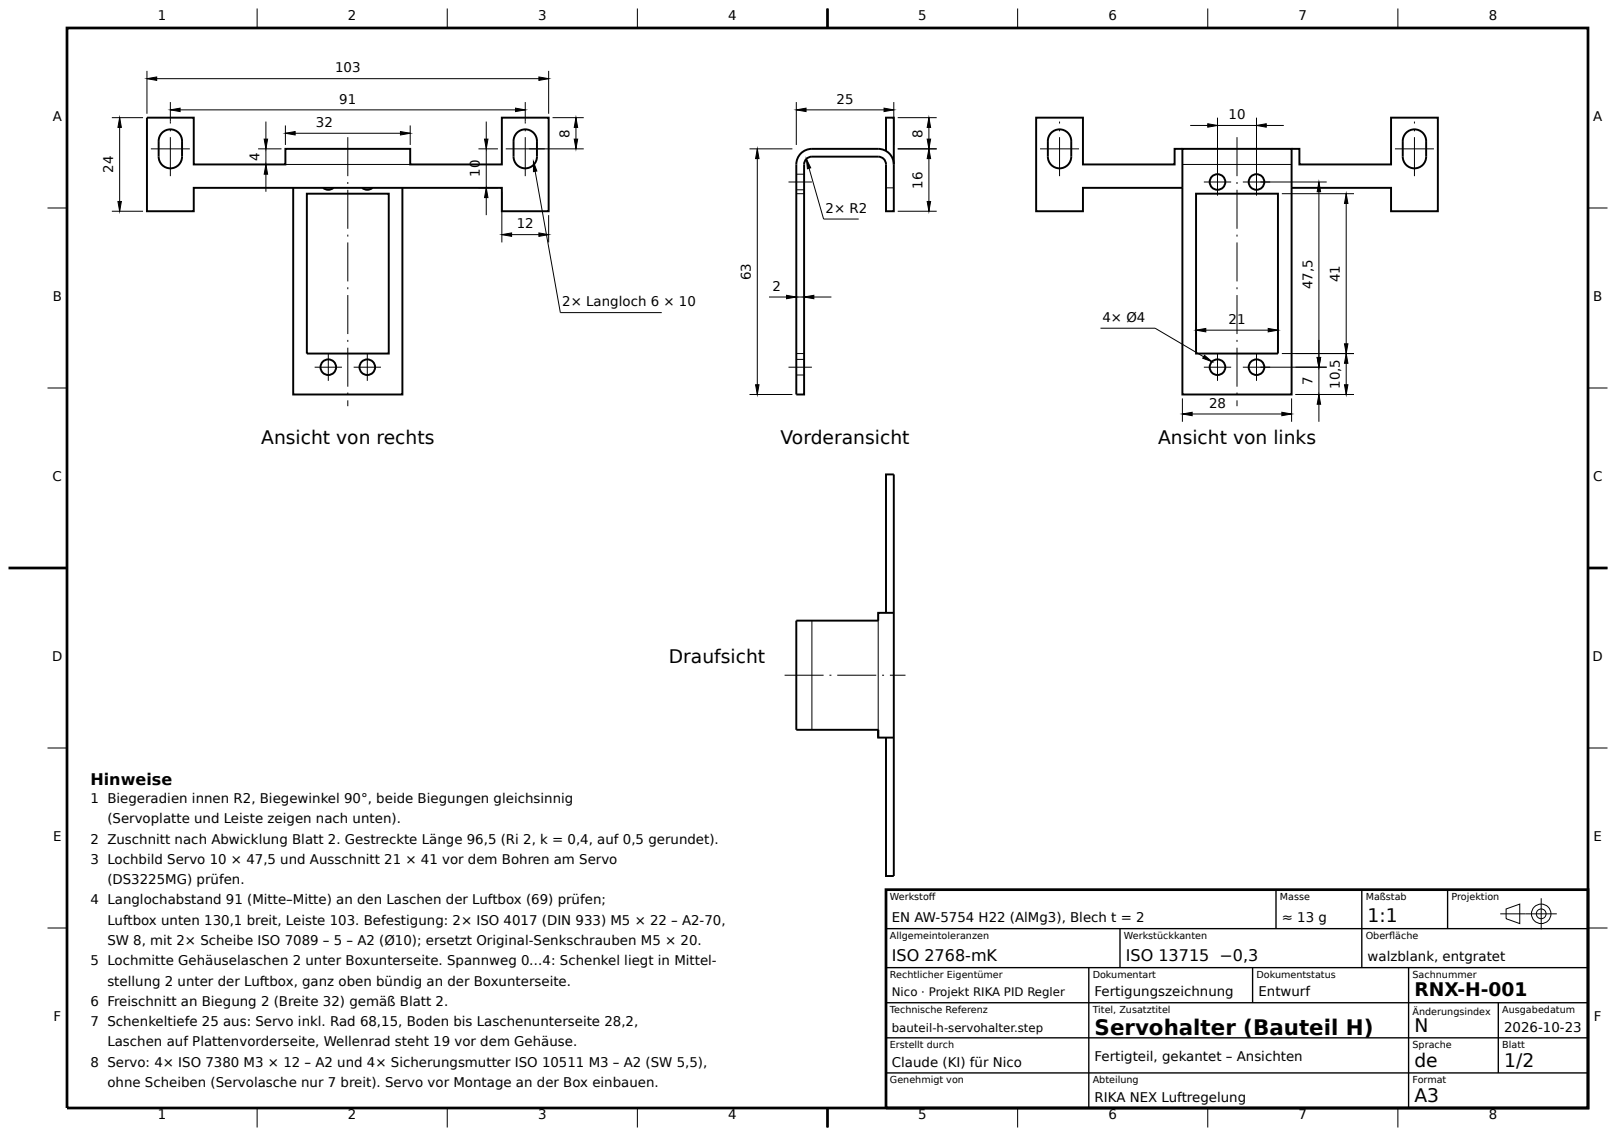
[picture p20: page 1]
Masse ≈ 13 g; Maßstab 1:1; Projektion; Werkstückkanten ISO 13715 −0,3; Oberfläche walzblank, entgratet; Dokumentart Fertigungszeichnung; Dokumentstatus Entwurf; Titel, Zusatztitel Servohalter (Bauteil H); Abteilung RIKA NEX Luftregelung; Sachnummer RNX-H-001; Änderungsindex N; Ausgabedatum 2026-10-23; Sprache de; Blatt 1/2; Format A3; Vorderansicht; 2× Langloch 6 × 10; Draufsicht

Ansicht von links

Ansicht von rechts

Hinweise
1 Biegeradien innen R2, Biegewinkel 90°, beide Biegungen gleichsinnig
(Servoplatte und Leiste zeigen nach unten).
2 Zuschnitt nach Abwicklung Blatt 2. Gestreckte Länge 96,5 (Ri 2, k = 0,4, auf 0,5 gerundet).
3 Lochbild Servo 10 × 47,5 und Ausschnitt 21 × 41 vor dem Bohren am Servo
(DS3225MG) prüfen.
4 Langlochabstand 91 (Mitte–Mitte) an den Laschen der Luftbox (69) prüfen;
Luftbox unten 130,1 breit, Leiste 103. Befestigung: 2× ISO 4017 (DIN 933) M5 × 22 – A2-70,
SW 8, mit 2× Scheibe ISO 7089 – 5 – A2 (Ø10); ersetzt Original-Senkschrauben M5 × 20.
5 Lochmitte Gehäuselaschen 2 unter Boxunterseite. Spannweg 0…4: Schenkel liegt in Mittel-
stellung 2 unter der Luftbox, ganz oben bündig an der Boxunterseite.
6 Freischnitt an Biegung 2 (Breite 32) gemäß Blatt 2.
7 Schenkeltiefe 25 aus: Servo inkl. Rad 68,15, Boden bis Laschenunterseite 28,2,
Laschen auf Plattenvorderseite, Wellenrad steht 19 vor dem Gehäuse.
8 Servo: 4× ISO 7380 M3 × 12 – A2 und 4× Sicherungsmutter ISO 10511 M3 – A2 (SW 5,5),
ohne Scheiben (Servolasche nur 7 breit). Servo vor Montage an der Box einbauen.

Werkstoff
EN AW-5754 H22 (AlMg3), Blech t = 2
Allgemeintoleranzen
ISO 2768-mK

Rechtlicher Eigentümer
Nico · Projekt RIKA PID Regler
Technische Referenz
bauteil-h-servohalter.step
Erstellt durch
Claude (KI) für Nico
Genehmigt von

Fertigteil, gekantet – Ansichten

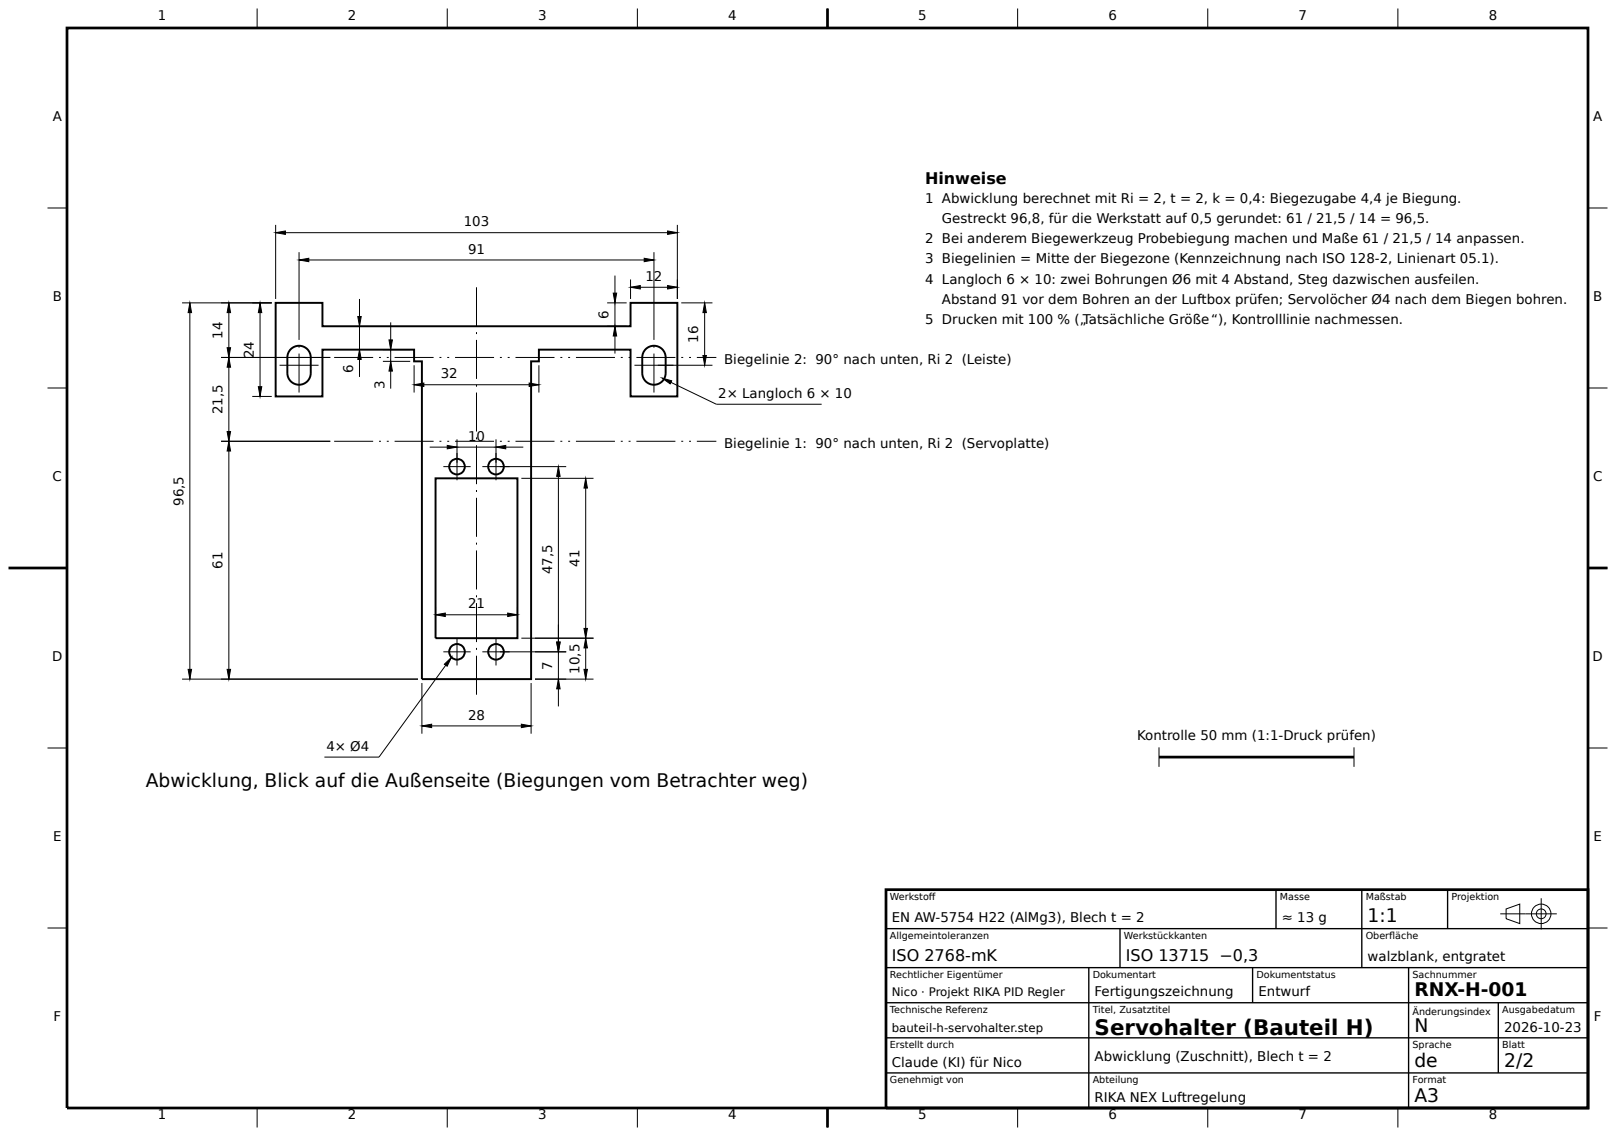
[picture p21: page 2]
Masse ≈ 13 g; Maßstab 1:1; Projektion; Werkstückkanten ISO 13715 −0,3; Oberfläche walzblank, entgratet; Dokumentart Fertigungszeichnung; Dokumentstatus Entwurf; Titel, Zusatztitel Servohalter (Bauteil H); Abteilung RIKA NEX Luftregelung; Sachnummer RNX-H-001; Änderungsindex N; Ausgabedatum 2026-10-23; Sprache de; Blatt 2/2; Format A3; 2× Langloch 6 × 10

Hinweise
1 Abwicklung berechnet mit Ri = 2, t = 2, k = 0,4: Biegezugabe 4,4 je Biegung.
Gestreckt 96,8, für die Werkstatt auf 0,5 gerundet: 61 / 21,5 / 14 = 96,5.
2 Bei anderem Biegewerkzeug Probebiegung machen und Maße 61 / 21,5 / 14 anpassen.
3 Biegelinien = Mitte der Biegezone (Kennzeichnung nach ISO 128-2, Linienart 05.1).
4 Langloch 6 × 10: zwei Bohrungen Ø6 mit 4 Abstand, Steg dazwischen ausfeilen.
Abstand 91 vor dem Bohren an der Luftbox prüfen; Servolöcher Ø4 nach dem Biegen bohren.
5 Drucken mit 100 % („Tatsächliche Größe“), Kontrolllinie nachmessen.

Biegelinie 2: 90° nach unten, Ri 2 (Leiste)

Biegelinie 1: 90° nach unten, Ri 2 (Servoplatte)

Kontrolle 50 mm (1:1-Druck prüfen)

Abwicklung, Blick auf die Außenseite (Biegungen vom Betrachter weg)

Werkstoff
EN AW-5754 H22 (AlMg3), Blech t = 2
Allgemeintoleranzen
ISO 2768-mK

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

Abwicklung (Zuschnitt), Blech t = 2
