vauntro/rika-nex-airflow-controller/hardware/schaltplan/rika-nex-steuerung.kicad_sch

## KiCad design hardware/schaltplan/rika-nex-steuerung.kicad_sch (2026-11-06)

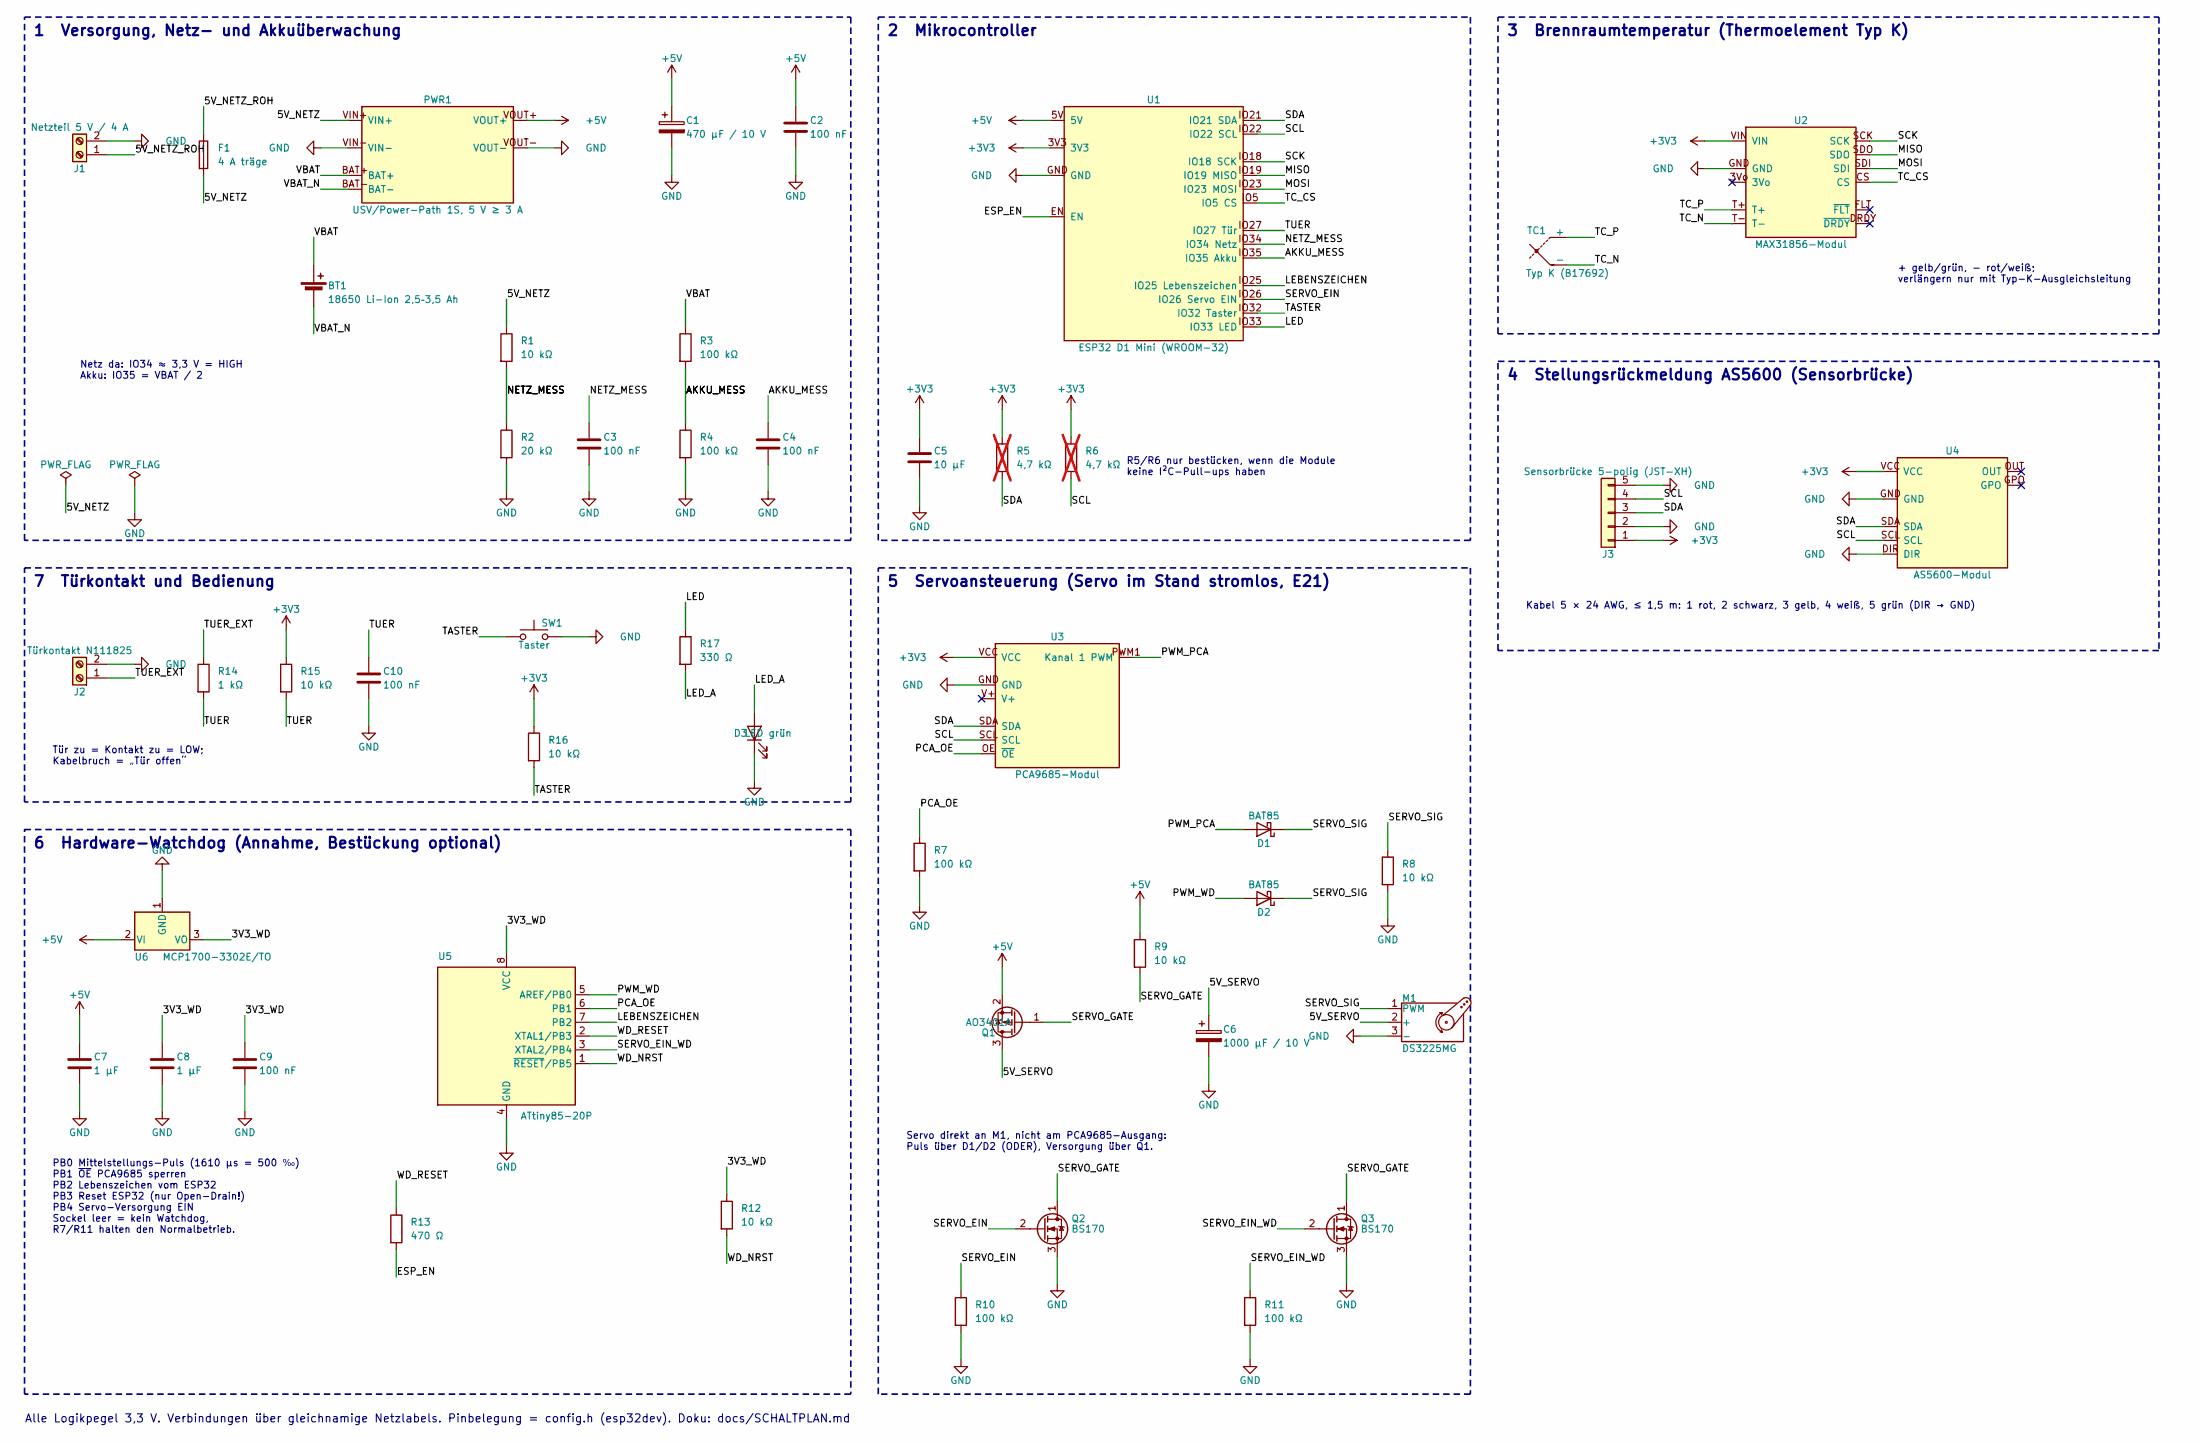
[picture p22: schematic rika-nex-steuerung.kicad_sch]

Parts:
BT1: 18650 Li-Ion 2,5–3,5 Ah
C1: 470 µF / 10 V; CP_Radial_D8.0mm_P3.50mm
C2, C3, C4, C9, C10: 100 nF; C_Disc_D5.0mm_W2.5mm_P5.00mm
C5: 10 µF; C_Disc_D5.0mm_W2.5mm_P5.00mm
C6: 1000 µF / 10 V; CP_Radial_D10.0mm_P5.00mm
C7, C8: 1 µF; C_Disc_D5.0mm_W2.5mm_P5.00mm
D1, D2: BAT85; D_DO-35_SOD27_P7.62mm_Horizontal
D3: LED grün; LED_D3.0mm
F1: 4 A träge; Fuseholder_Cylinder-5x20mm_Schurter_0031_8201_Horizontal_Op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
J1: Netzteil 5 V / 4 A; TerminalBlock_Phoenix_MKDS-1,5-2-5.08_1x02_P5.08mm_Horizont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
J2: Türkontakt N111825; TerminalBlock_Phoenix_MKDS-1,5-2-5.08_1x02_P5.08mm_Horizont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
J3: Sensorbrücke 5-polig (JST-XH); JST_XH_B5B-XH-A_1x05_P2.50mm_Vertical
M1: DS3225MG; PinHeader_1x03_P2.54mm_Vertical
PWR1: USV/Power-Path 1S, 5 V ≥ 3 A
Q1: AO3401A; SOT-23
Q2, Q3: BS170; TO-92_Inline
R1, R8, R9, R12, R15, R16: 10 kΩ; R_Axial_DIN0207_L6.3mm_D2.5mm_P10.16mm_Horizontal
R2: 20 kΩ; R_Axial_DIN0207_L6.3mm_D2.5mm_P10.16mm_Horizontal
R3, R4, R7, R10, R11: 100 kΩ; R_Axial_DIN0207_L6.3mm_D2.5mm_P10.16mm_Horizontal
R5, R6: 4,7 kΩ; R_Axial_DIN0207_L6.3mm_D2.5mm_P10.16mm_Horizontal; not fitted
R13: 470 Ω; R_Axial_DIN0207_L6.3mm_D2.5mm_P10.16mm_Horizontal
R14: 1 kΩ; R_Axial_DIN0207_L6.3mm_D2.5mm_P10.16mm_Horizontal
R17: 330 Ω; R_Axial_DIN0207_L6.3mm_D2.5mm_P10.16mm_Horizontal
SW1: Taster; SW_PUSH_6mm
TC1: Typ K (B17692)
U1: ESP32 D1 Mini (WROOM-32)
U2: MAX31856-Modul
U3: PCA9685-Modul
U4: AS5600-Modul
U5: ATtiny85-20P; DIP-8_W7.62mm_Socket
U6: MCP1700-3302E/TO; TO-92_Inline

Connections:
3V3_WD: C8.1, C9.1, R12.1, U5.8 (VCC), U6.3 (VO)
5V_NETZ: F1.2, PWR1.VIN+, R1.1
5V_NETZ_ROH: F1.1, J1.1
5V_SERVO: C6.1, M1.2 (+), Q1.3 (D)
+3V3: C5.1, J3.1, R5.1, R6.1, R15.1, R16.1, U1.3V3, U2.VIN, U3.VCC, U4.VCC
+5V: C1.1, C2.1, C7.1, PWR1.VOUT+, Q1.2 (S), R9.1, U1.5V, U6.2 (VI)
AKKU_MESS: C4.1, R3.2, R4.1, U1.IO35 (IO35 Akku)
ESP_EN: R13.2, U1.EN
GND: C1.2, C2.2, C3.2, C4.2, C5.2, C6.2, C7.2, C8.2, C9.2, C10.2, D3.1 (K), J1.2, J2.2, J3.2, J3.5, M1.3 (-), PWR1.VIN- (VIN−), PWR1.VOUT- (VOUT−), Q2.3 (S), Q3.3 (S), R2.2, R4.2, R7.2, R8.2, R10.2, R11.2, SW1.2, U1.GND, U2.GND, U3.GND, U4.DIR, U4.GND, U5.4 (GND), U6.1 (GND)
LEBENSZEICHEN: U1.IO25 (IO25 Lebenszeichen), U5.7 (PB2)
LED: R17.1, U1.IO33 (IO33 LED)
LED_A: D3.2 (A), R17.2
MISO: U1.IO19 (IO19 MISO), U2.SDO
MOSI: U1.IO23 (IO23 MOSI), U2.SDI
NETZ_MESS: C3.1, R1.2, R2.1, U1.IO34 (IO34 Netz)
PCA_OE: R7.1, U3.OE (~OE), U5.6 (PB1)
PWM_PCA: D1.2 (A), U3.PWM1 (Kanal 1 PWM)
PWM_WD: D2.2 (A), U5.5 (AREF/PB0)
SCK: U1.IO18 (IO18 SCK), U2.SCK
SCL: J3.4, R6.2, U1.IO22 (IO22 SCL), U3.SCL, U4.SCL
SDA: J3.3, R5.2, U1.IO21 (IO21 SDA), U3.SDA, U4.SDA
SERVO_EIN: Q2.2 (G), R10.1, U1.IO26 (IO26 Servo EIN)
SERVO_EIN_WD: Q3.2 (G), R11.1, U5.3 (XTAL2/PB4)
SERVO_GATE: Q1.1 (G), Q2.1 (D), Q3.1 (D), R9.2
SERVO_SIG: D1.1 (K), D2.1 (K), M1.1 (PWM), R8.1
TASTER: R16.2, SW1.1, U1.IO32 (IO32 Taster)
TC_CS: U1.IO5 (IO5 CS), U2.CS
TC_N: TC1.2 (-), U2.T-
TC_P: TC1.1 (+), U2.T+
TUER: C10.1, R14.2, R15.2, U1.IO27 (IO27 Tür)
TUER_EXT: J2.1, R14.1
VBAT: BT1.1 (+), PWR1.BAT+, R3.1
VBAT_N: BT1.2 (-), PWR1.BAT- (BAT−)
WD_NRST: R12.2, U5.1 (~RESET/PB5)
WD_RESET: R13.1, U5.2 (XTAL1/PB3)

Notes on the sheet:
1 Versorgung, Netz- und Akkuüberwachung
Netz da: IO34 ≈ 3,3 V = HIGH Akku: IO35 = VBAT / 2
2 Mikrocontroller
R5/R6 nur bestücken, wenn die Module keine I²C-Pull-ups haben
3 Brennraumtemperatur (Thermoelement Typ K)
+ gelb/grün, − rot/weiß; verlängern nur mit Typ-K-Ausgleichsleitung
4 Stellungsrückmeldung AS5600 (Sensorbrücke)
Kabel 5 × 24 AWG, ≤ 1,5 m: 1 rot, 2 schwarz, 3 gelb, 4 weiß, 5 grün (DIR → GND)
5 Servoansteuerung (Servo im Stand stromlos, E21)
Servo direkt an M1, nicht am PCA9685-Ausgang: Puls über D1/D2 (ODER), Versorgung über Q1.
6 Hardware-Watchdog (Annahme, Bestückung optional)
PB0 Mittelstellungs-Puls (1610 µs = 500 ‰) PB1 ~{OE} PCA9685 sperren PB2 Lebenszeichen vom ESP32 PB3 Reset ESP32 (nur Open-Drain!) PB4 Servo-Versorgung EIN Sockel leer = kein Watchdog, R7/R11 halten den Normalbetrieb.
7 Türkontakt und Bedienung
Tür zu = Kontakt zu = LOW; Kabelbruch = „Tür offen“
Alle Logikpegel 3,3 V. Verbindungen über gleichnamige Netzlabels. Pinbelegung = config.h (esp32dev). Doku: docs/SCHALTPLAN.md
