vauntro/rika-nex-airflow-controller/firmware/rika-nex-controller/include/secrets.example.h

// Kopieren nach include/secrets.h und ausfüllen. secrets.h wird nicht eingecheckt.
#pragma once

#define WIFI_SSID     "mein-wlan"
#define WIFI_PASSWORD "geheim"

#define MQTT_HOST     "192.168.1.10"   // Broker-VM
#define MQTT_PORT     1883
#define MQTT_USER     "rika"
#define MQTT_PASSWORD "geheim"

#define OTA_PASSWORD  "geheim"
