vauntro/rika-nex-airflow-controller/(commit log)

2026-10-27 Planung, Doku und CAD-Daten aus dem Projekt übernehmen
    Projektpläne v1-v3, Beschreibung der Luftbox, Home-Assistant-Werte,
    Servohalter und GT2-Riemenrad (STEP/STL/Zeichnungen). README ergänzt.
    Herstellerhandbücher bewusst nicht enthalten (Urheberrecht).
    Claude-Session: https://claude.ai/code/session_01N1SdfYLTYNDgxTqipk9kMn
    [bauteil-h-servohalter.step, bauteil-h-servohalter.stl, riemenrad-gt2-20t-servo25t.step, riemenrad-gt2-20t-servo25t.stl]
2026-10-27 Firmware 0.3.2 (Luftbox, Servo zu = 2360 µs) und aktuelle Doku übernehmen
    - firmware/rika-nex-controller/: PlatformIO-Projekt (ESP32, MQTT/HA-Discovery,
    Luftbox-Servo mit AS5600), Stand FW_VERSION 0.3.2-luftbox, AIR_US_AT_0 = 2360 µs
    (am 27.10. gemessen: vollständig geschlossen). secrets.h bleibt lokal,
    nur secrets.example.h mit Platzhaltern.
    - docs/: OFFENE-PUNKTE.md, KALIBRIERUNG.md, MECHANIK.md
    - home-assistant/rika-nex-dashboard.yaml
    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
2026-10-27 LIESMICH der Firmware auf Stand 0.3.2 (zu = 2360 µs) bringen
    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
2026-10-27 README: Pfade auf Firmware 0.3.2 und HA-Dashboard aktualisieren
    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
2026-10-27 Zeichnung der Luftbox entfernen (Urheberrecht)
    Die Zeichnung zeichnung-luftbox-riemenantrieb-as5600.png soll nicht im
    Repo liegen. Verweise in README, MECHANIK.md und projektplan-v3.md
    angepasst.
    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
2026-10-27 Plan: Umstieg auf ESP32 für den Produktivbetrieb (E20), CHANGELOG angelegt
    Claude-Session: https://claude.ai/code/session_01JTf7iqfsy9wGhZchLuckgv
2026-10-28 Dauer- und Stresstest Antrieb dokumentiert: freigegeben
    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
2026-11-06 Hardware: AS5600-Sensorbrücke für die Rückseite der Luftbox
    Flache Brücke aus 2-mm-Alublech (163 x 16, Mittelplatte 32 x 32) an den
    mittleren Laschen (Lochabstand 147) mit M5 x 22 und Distanzhülsen 12 mm.
    Platine auf Abstandshaltern M3 x 6, Fenster 17 x 11 für die Stecker.
    STEP, STL, DXF, Zeichnung 1:1, Erzeugungsskripte und Entwurfsskizzen.
    MECHANIK.md, OFFENE-PUNKTE.md, Projektplan E16, README und CHANGELOG
    nachgezogen.
    Claude-Session: https://claude.ai/code/session_01N1SdfYub6sPD2vdLpBbhXf
    [sensorbruecke-as5600.dxf, sensorbruecke-as5600.step, sensorbruecke-as5600.stl]
2026-11-06 Sensorbrücke AS5600 schmaler: Steg 8 mm, Mittelplatte 24 x 24
    Auf Nicos Wunsch, damit die Brücke möglichst wenig Luft verdeckt. Augen
    Ø 14 um die M5-Bohrungen, Übergänge R 2, Länge 161. Modell, DXF und
    Zeichnung neu erzeugt; die Zeichnung liest die Kontur jetzt aus dem
    CAD-Modell. README, MECHANIK.md und CHANGELOG angepasst.
    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
    [sensorbruecke-as5600.dxf, sensorbruecke-as5600.step, sensorbruecke-as5600.stl]
2026-11-06 Sensorbrücke AS5600: ISO-Fertigungszeichnung A4 (RNX-S-001)
    Fertigungszeichnung im Stil des Servohalters (Bauteil H), A4 quer im
    Maßstab 1:1 mit Schriftfeld nach ISO 7200. Blatt 1: Vorderansicht,
    Draufsicht, Ansicht von links mit Bemaßung. Blatt 2: schematischer
    Schnitt durch die Wellenmitte und Montagehinweise. Erzeugt mit
    quelle/zeichnung_iso.py aus dem CAD-Modell.
    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
2026-11-06 Sensorbrücke AS5600: Befestigung M5 x 30, Einkaufsliste
    Laschen der Luftbox sind 6,2 mm dick (gemessen Nico), M5 x 22 ist zu
    kurz. Jetzt ISO 4017 M5 x 30 mit Ganzmetall-Sicherungsmutter ISO 7042
    (Nylon-Stoppmutter verträgt die Wärme am Ofen nicht), Abstandshalter
    M3 aus Messing. Einkaufsliste im README, beide Zeichnungen neu erzeugt
    (ISO-Zeichnung Änderungsindex A), MECHANIK.md, OFFENE-PUNKTE.md und
    CHANGELOG angepasst.
    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
2026-11-06 Sensorbrücke AS5600: Montageanleitung als Explosionsdarstellung
    Gerendert aus vereinfachten CadQuery-Körpern (quelle/montage.py) mit
    Positionsnummern, Teileliste und Montageschritten. README und CHANGELOG
    ergänzt.
    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
2026-11-06 Sensorbrücke AS5600: 3D-Baugruppe als STEP und GLB
    Baugruppe aus quelle/montage.py (build) mit Einbaulage und
    Explosionslage, benannte und farbige Teile. Vorschaubild über
    quelle/vorschau.py. README und CHANGELOG ergänzt.
    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
    [sensorbruecke-as5600-baugruppe-explosion.step, sensorbruecke-as5600-baugruppe-montiert.step]
2026-11-06 Sensorbrücke AS5600: 3D-Baugruppe zusätzlich als STL
    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
    [sensorbruecke-as5600-baugruppe-explosion.step, sensorbruecke-as5600-baugruppe-explosion.stl, sensorbruecke-as5600-baugruppe-montiert.step, sensorbruecke-as5600-baugruppe-montiert.stl]
2026-11-06 Sensorbrücke AS5600: Sicherungsmutter DIN 985 statt ISO 7042
    An der Montagestelle wird es nicht heiß (Nico), daher Stoppmutter mit
    Nylonring DIN 985 M5 A2. Gleiche Höhe, Schraube M5 x 30 bleibt.
    README, Zeichnungen, Montageanleitung und Baugruppe neu erzeugt.
    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
    [sensorbruecke-as5600-baugruppe-explosion.step, sensorbruecke-as5600-baugruppe-montiert.step]
2026-11-06 Sensorbrücke AS5600: Anschlussbelegung mit 5 Adern dokumentiert
    DIR liegt laut Verkabelungsplan des Testaufbaus auf GND. Einkaufsliste
    auf 5-adriges Kabel mit Dupont- oder JST-XH-Stecker umgestellt.
    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
2026-11-06 Doku: Verkabelungsplan als docs/VERKABELUNG.md
    Aus dem Testaufbau (Logger-Firmware) übernommen und für den ESP32
    ergänzt: AS5600 mit DIR auf GND, PCA9685, Thermoelement, Türkontakt,
    Netzerkennung und Akku.
    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
2026-11-06 Planung: E21 Servo im Stand stromlos, Akku-Abschätzung
    Nico hat entschieden, den Servo nach Erreichen der Stellung abzuschalten.
    Energiebilanz für 6 h auf Akku im Projektplan (Abschnitt 2.3), offener
    Test zur Haltekraft des Riemenantriebs und Akku vs. Mini-DC-USV in
    OFFENE-PUNKTE.md, CHANGELOG ergänzt.
    Claude-Session: https://claude.ai/code/session_01N1SdfWGmFPRKvG9Toh9kb7
2026-11-06 Schaltplan: KiCad-Projekt der ESP32-Steuerung (Rev. A Entwurf)
    Vollständiger Schaltplan der Regler-Elektronik als KiCad-Projekt mit
    Projektbibliothek, PDF/PNG-Export und Generator-Skript:
    Versorgung (USV-/Power-Path-Modul, 18650, Netz- und Akkuüberwachung),
    ESP32 D1 Mini, MAX31856, AS5600, PCA9685, schaltbare Servoversorgung
    (E21), Dioden-ODER für den Servopuls, ATtiny85-Watchdog, Türkontakt,
    Taster und LED.
    Doku in docs/SCHALTPLAN.md, Annahmen in OFFENE-PUNKTE.md, neue GPIOs
    in config.h und VERKABELUNG.md, CHANGELOG ergänzt.
    Claude-Session: https://claude.ai/code/session_01N1SdfXz6SZkyG7cTf7zhsj
    [rika-nex-steuerung.kicad_sch]
